EnCl4/Alaris/Relatorio/TG2/PCBs.jpg

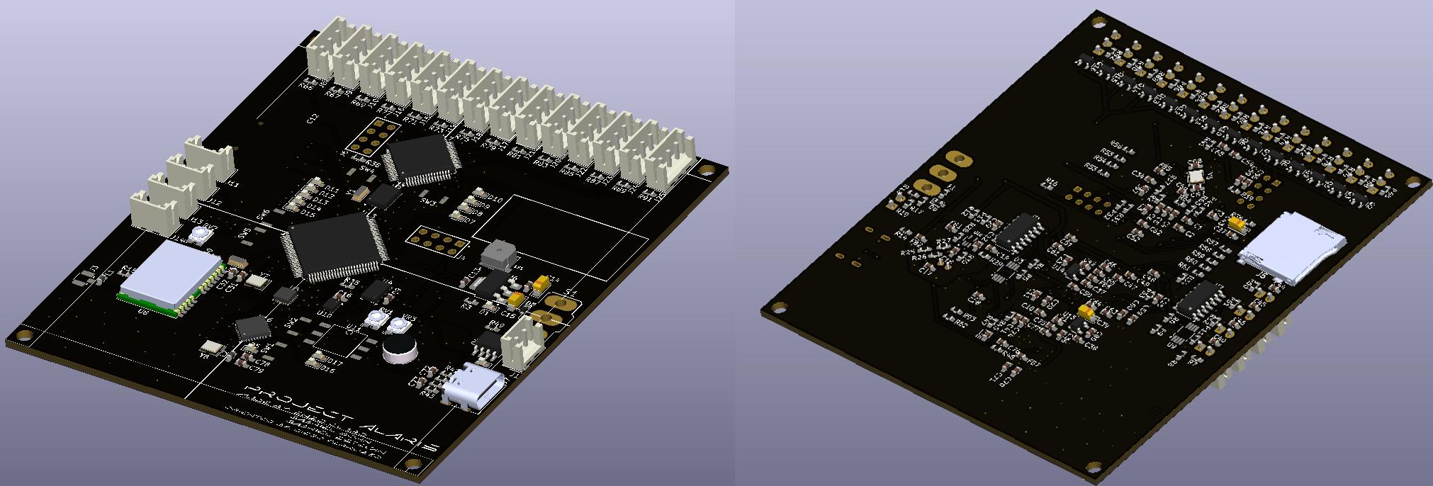
Relatorio/TG2/PCBs.jpg
