EnCl4/Alaris/Relatorio/TG1/Nova pasta/Tubo de pitot.PNG

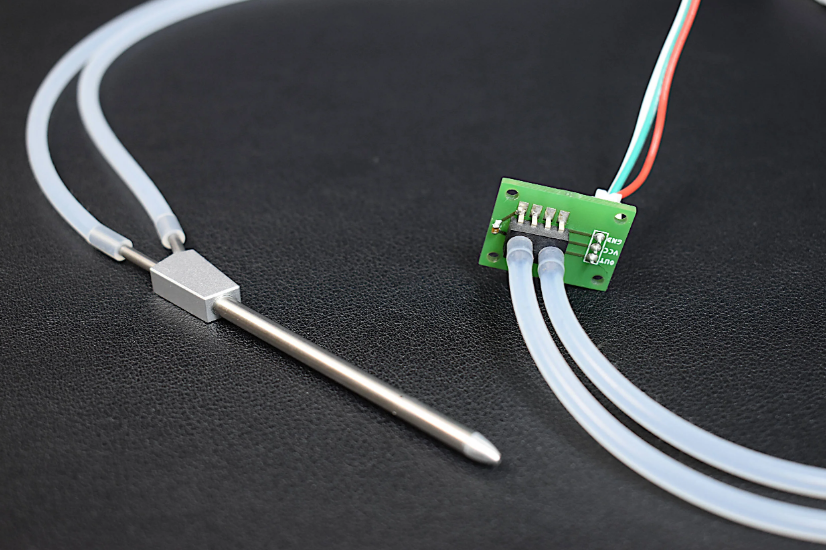
Relatorio/TG1/Nova pasta/Tubo de pitot.PNG
