EnCl4/Alaris/1762131913889.jpg

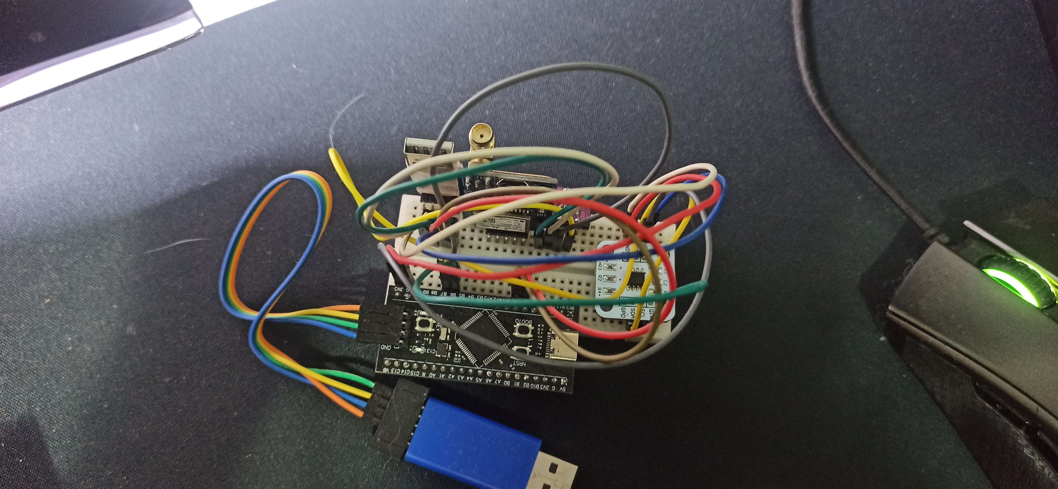
1762131913889.jpg
