EnCl4/Alaris/Capturar.PNG

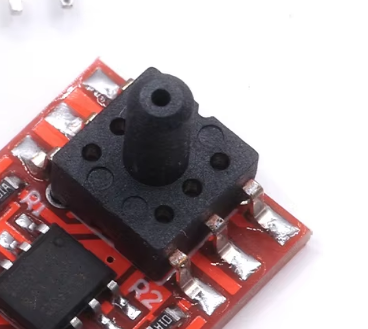
Capturar.PNG
