EnCl4/Alaris/DataGPS2.PNG

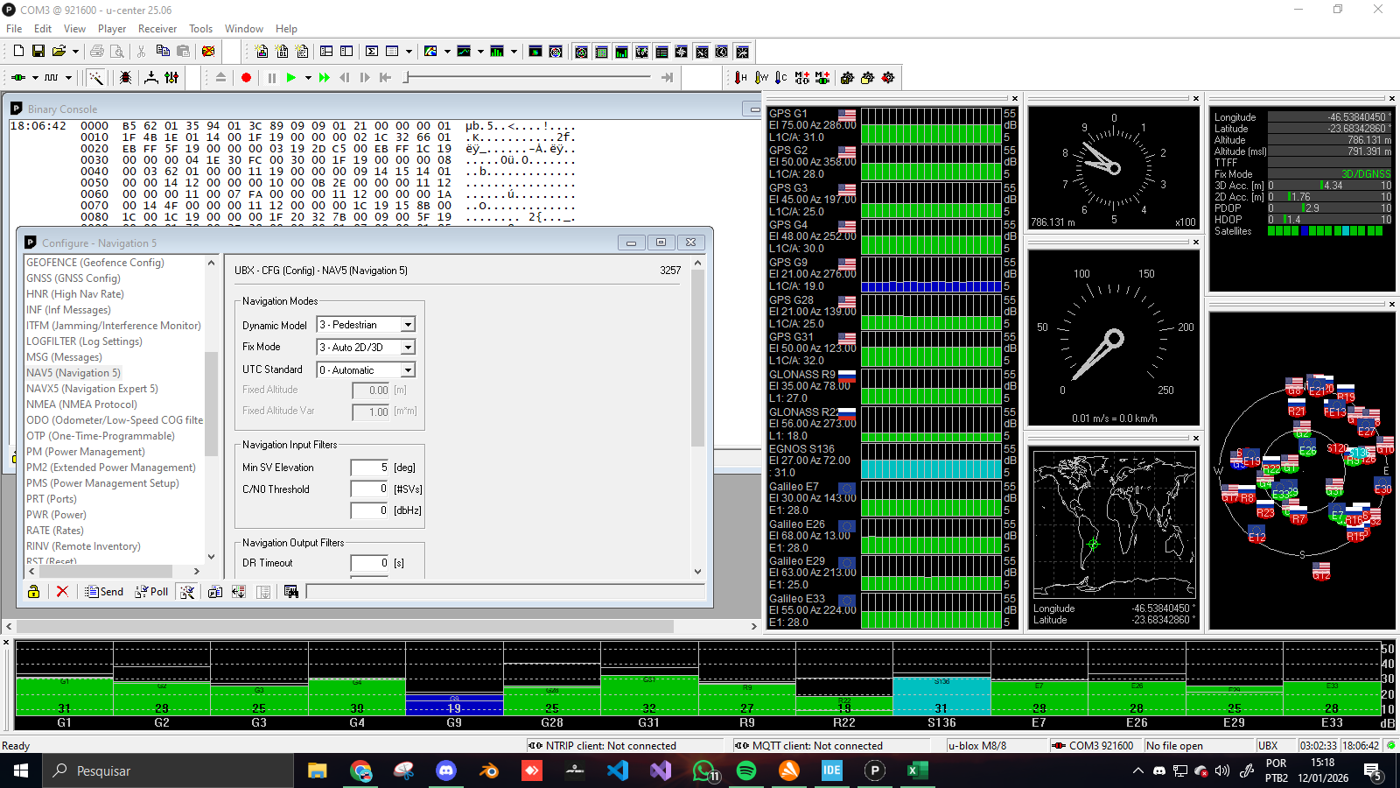
DataGPS2.PNG
