EnCl4/Alaris/GPSdata3.PNG

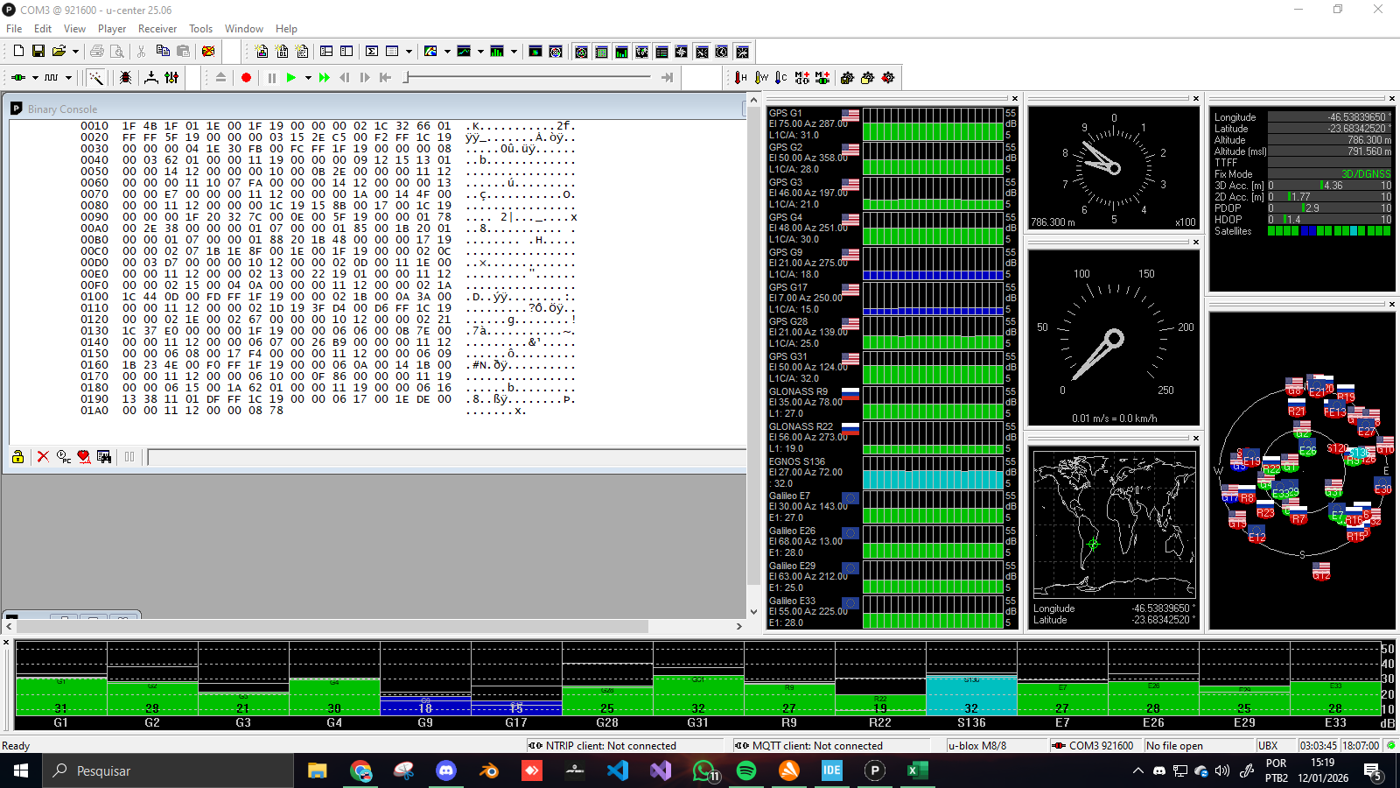
GPSdata3.PNG
