EnCl4/Alaris/GPSData.PNG

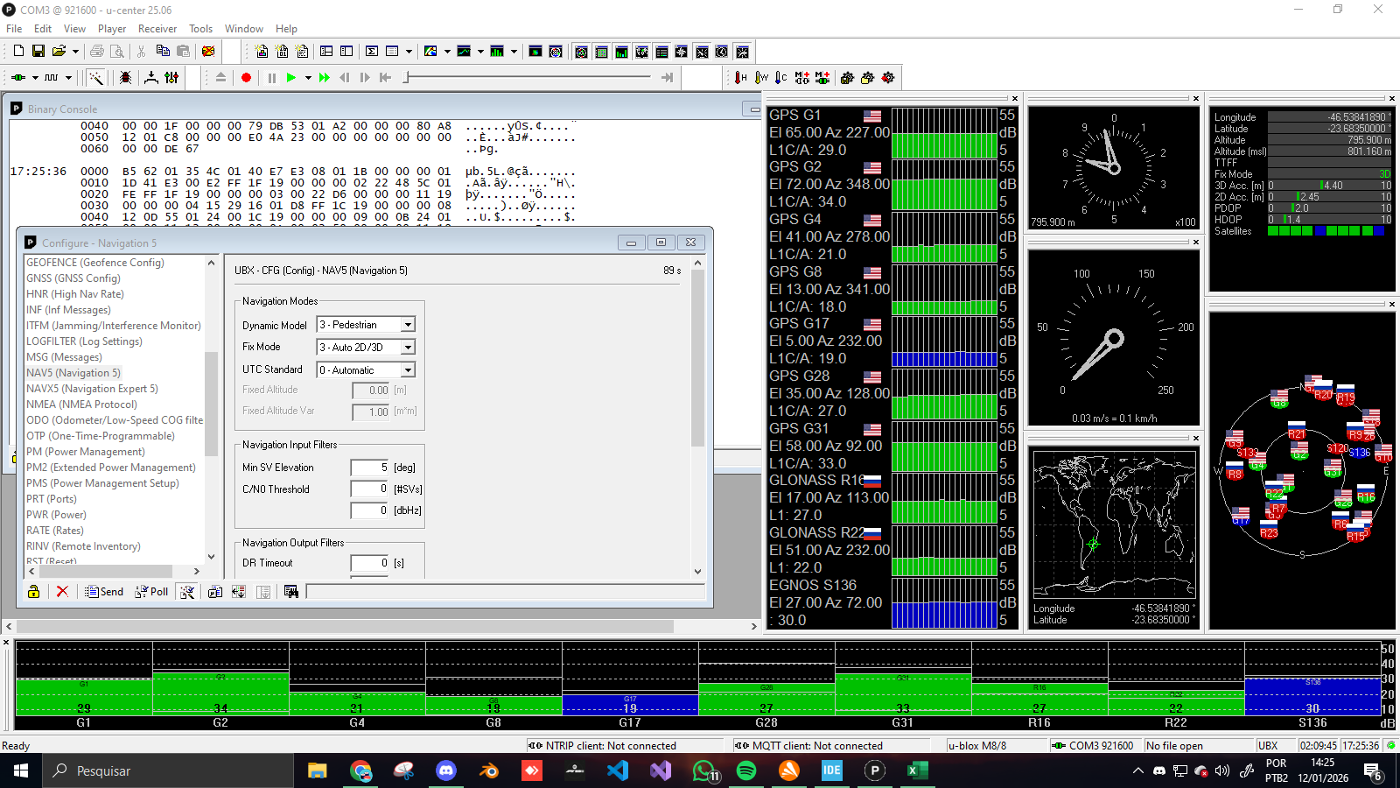
GPSData.PNG
