EnCl4/Alaris/Relatorio/TG1/Nova pasta/bateria-18650.jpg

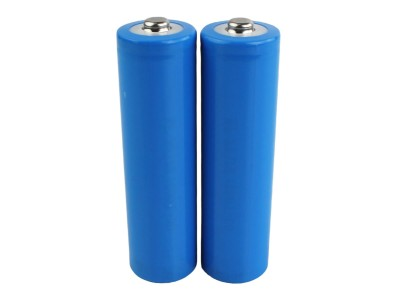
Relatorio/TG1/Nova pasta/bateria-18650.jpg
