EnCl4/Alaris/Relatorio/TG1/Nova pasta/CFD_ASA.png

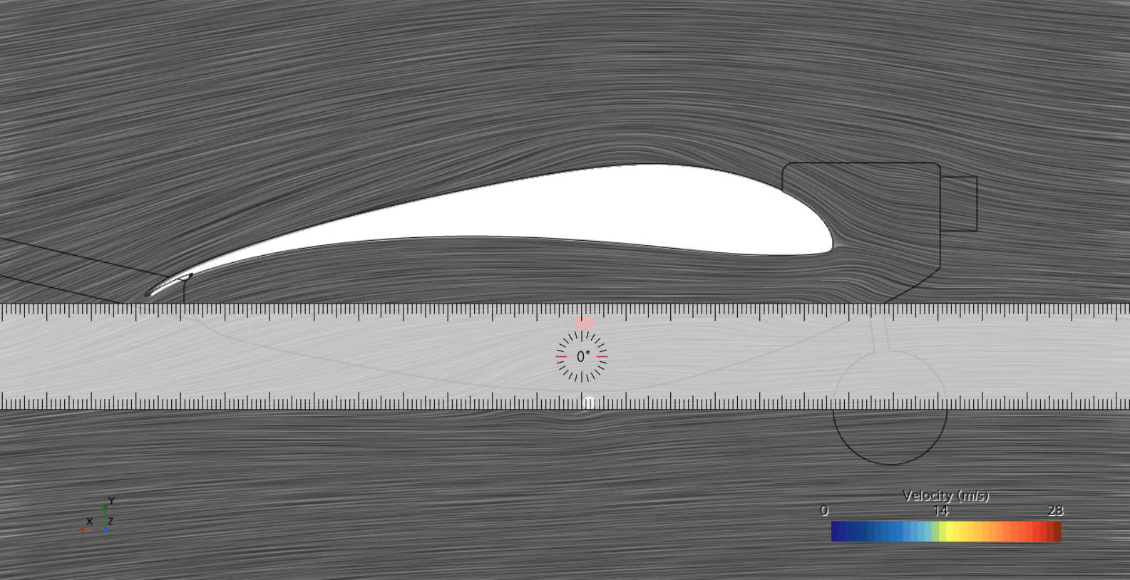
Relatorio/TG1/Nova pasta/CFD_ASA.png
