EnCl4/Alaris/Relatorio/TG1/Nova pasta/DiagramaHardware.png

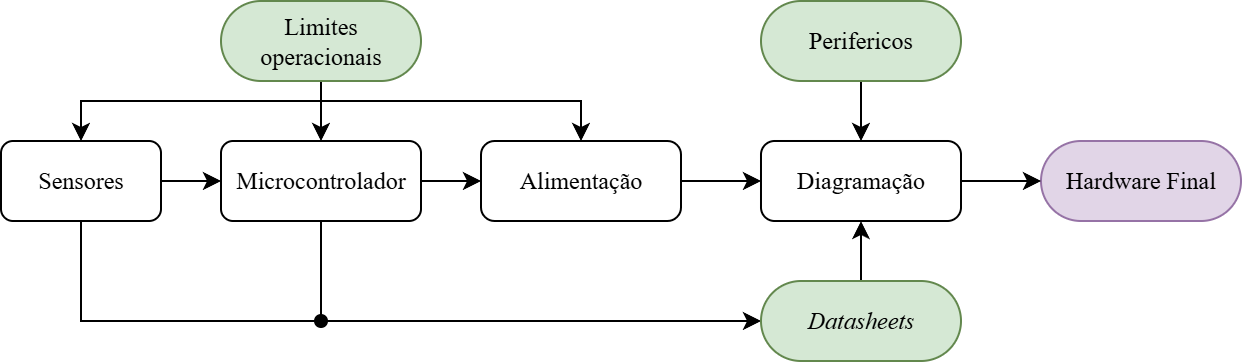
Relatorio/TG1/Nova pasta/DiagramaHardware.png
