EnCl4/Alaris/Relatorio/TG2/FluxoEmbarcado.png

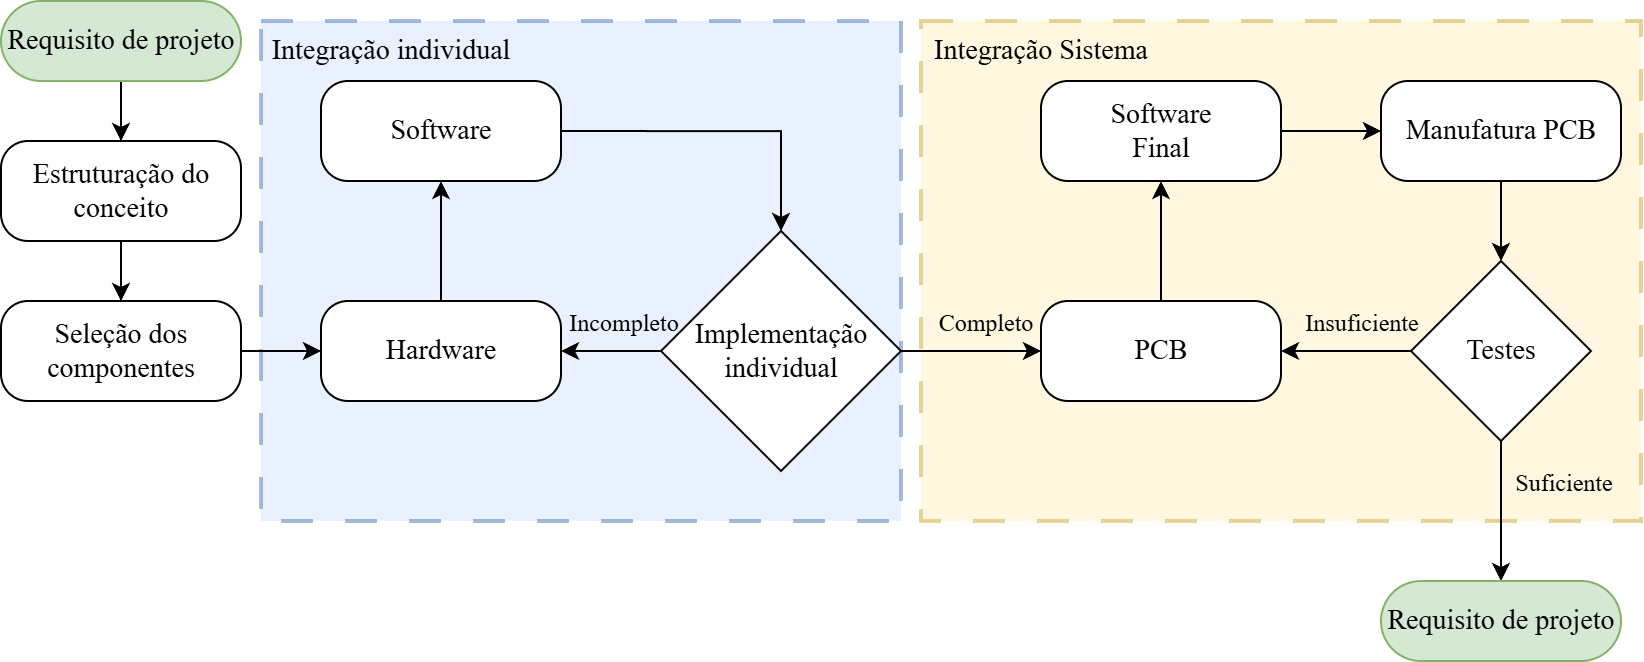
Relatorio/TG2/FluxoEmbarcado.png
