EnCl4/Alaris/Relatorio/TG2/FluxoPDN.png

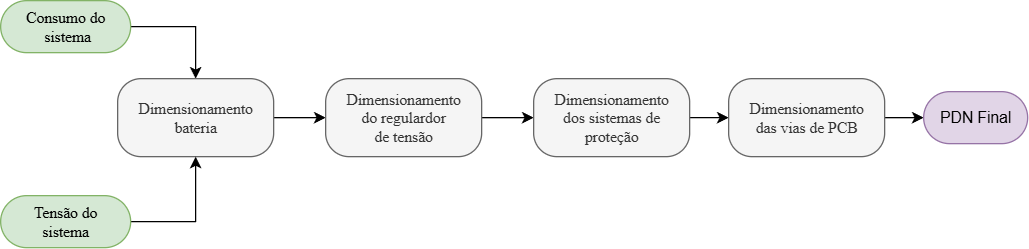
Relatorio/TG2/FluxoPDN.png
