EnCl4/Alaris/Relatorio/TG2/PCBDistribution.jpg

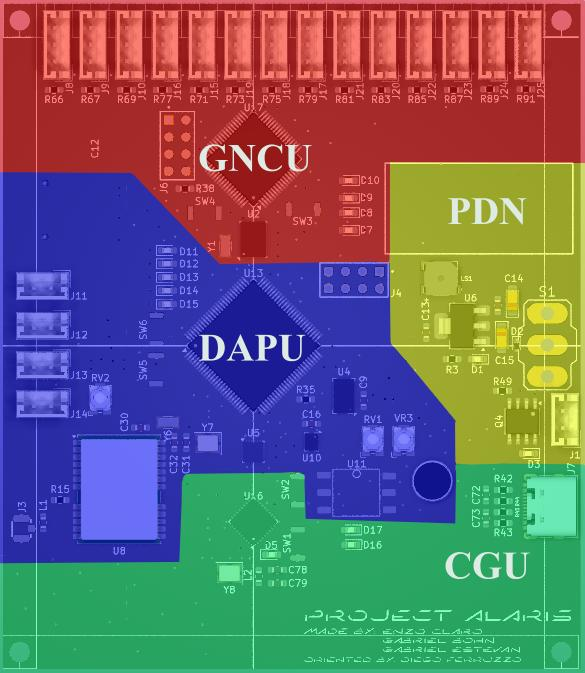
Relatorio/TG2/PCBDistribution.jpg
