EnCl4/Alaris/Relatorio/TG2/SoftwareFlux.png

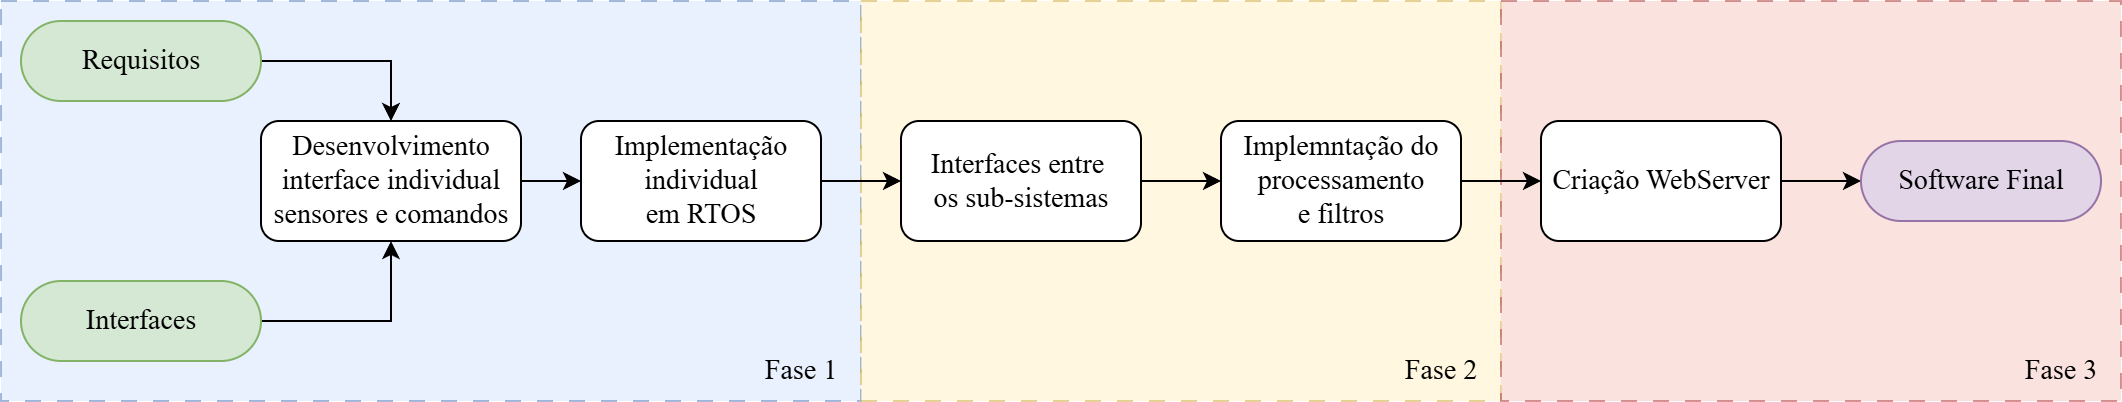
Relatorio/TG2/SoftwareFlux.png
