EnCl4/Alaris/Relatorio/TG2/SubSistemas.png

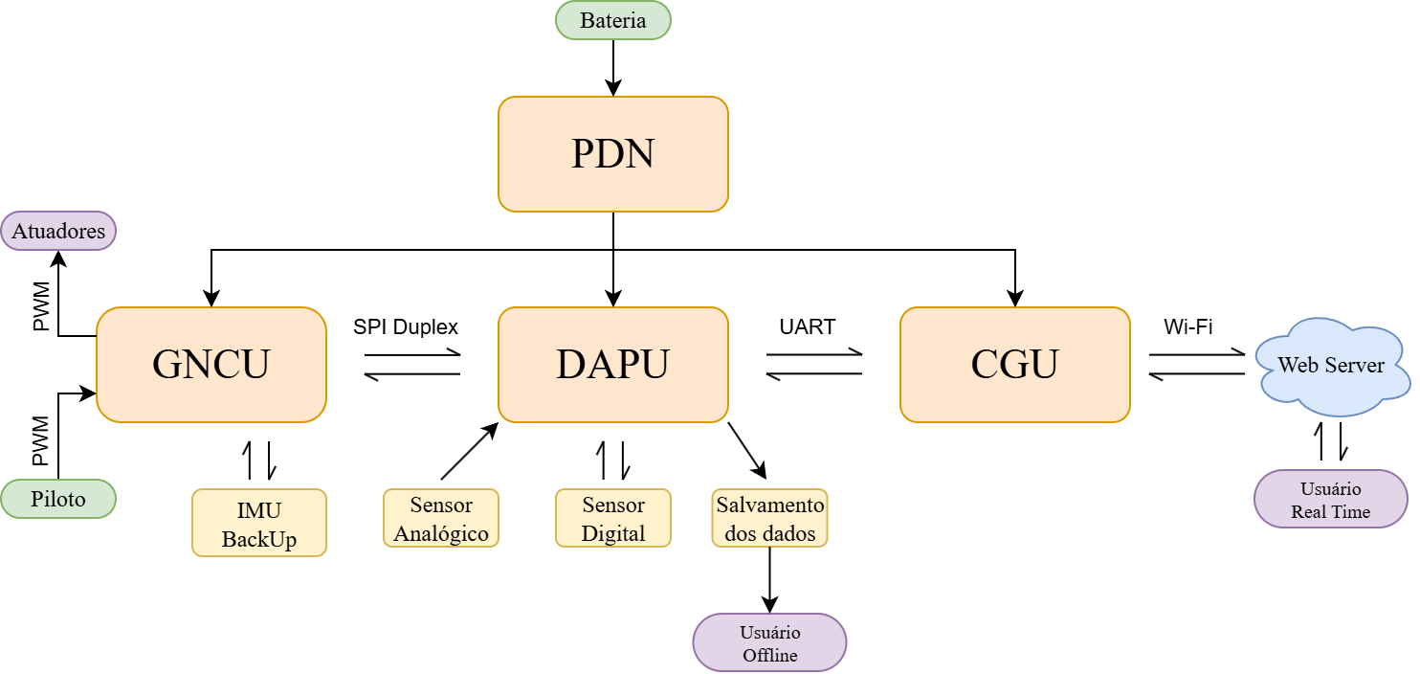
Relatorio/TG2/SubSistemas.png
