EnCl4/Alaris/Alaris - Hardware/Biblioteca/Step/TC33X-2-104E.STEP

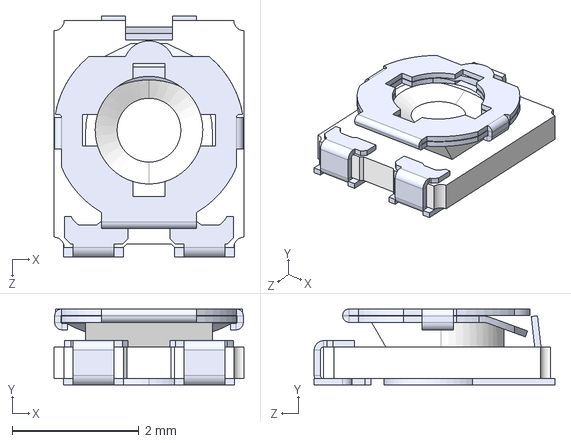
[picture p16: CAD file, 2026-04-19]
Alaris - Hardware/Biblioteca/Step/TC33X-2-104E.STEP
3.00 x 1.20 x 3.80 mm
