EnCl4/Alaris/Alaris - Hardware/Biblioteca/Step/MTMM-104-06-L-D-260.stp

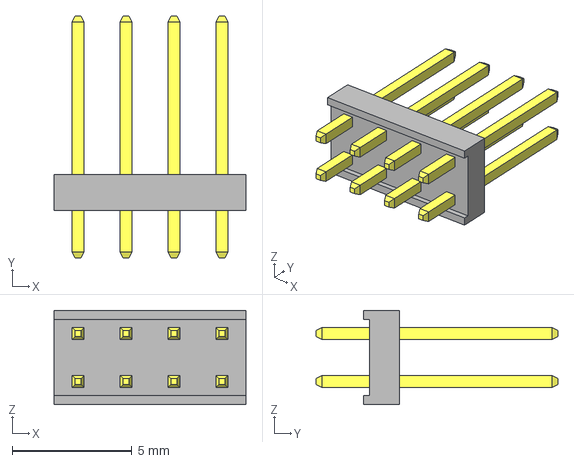
[picture p17: CAD file, 2026-04-19]
Alaris - Hardware/Biblioteca/Step/MTMM-104-06-L-D-260.stp
8.00 x 10.1 x 3.94 mm
MTMM-104-06-L-D-260_pins
MTMM-104-06-L-D-260_body
