EnCl4/Alaris/Alaris - Hardware/Biblioteca/Step/Buzzer5mm.step

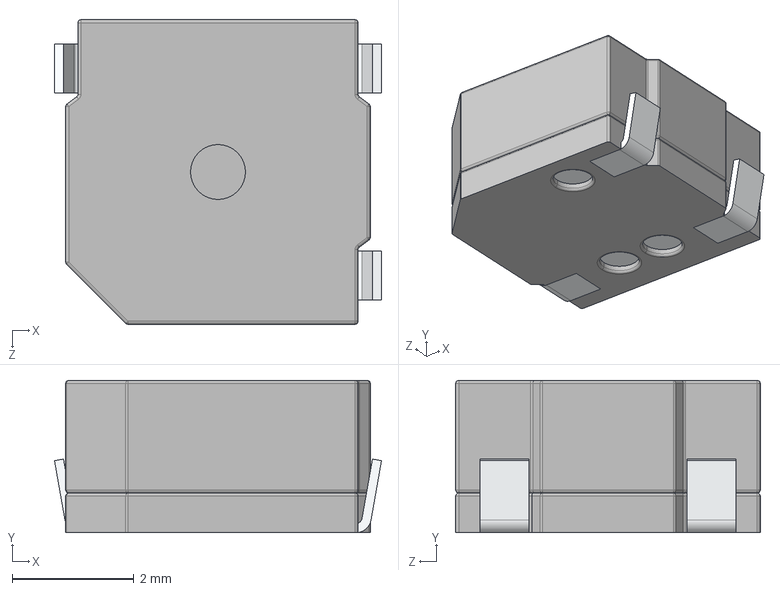
[picture p18: CAD file, 2026-04-19]
Alaris - Hardware/Biblioteca/Step/Buzzer5mm.step
5.37 x 2.50 x 5.00 mm
