EnCl4/Alaris/Alaris - Hardware/Biblioteca/Step/NEO-M8N-0-10.STEP

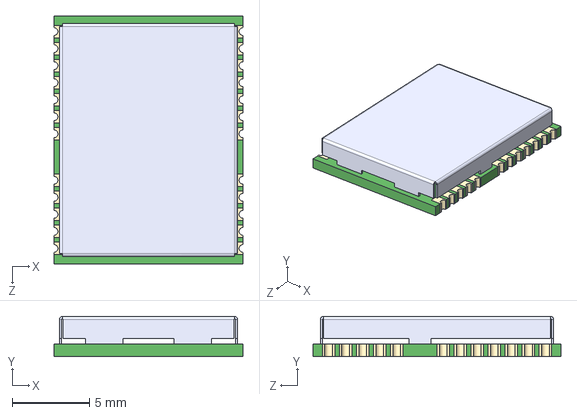
[picture p19: CAD file, 2026-04-19]
Alaris - Hardware/Biblioteca/Step/NEO-M8N-0-10.STEP
12.2 x 2.60 x 16.0 mm
