EnCl4/Alaris/Alaris - Hardware/Biblioteca/Step/ESP32-C3.STEP

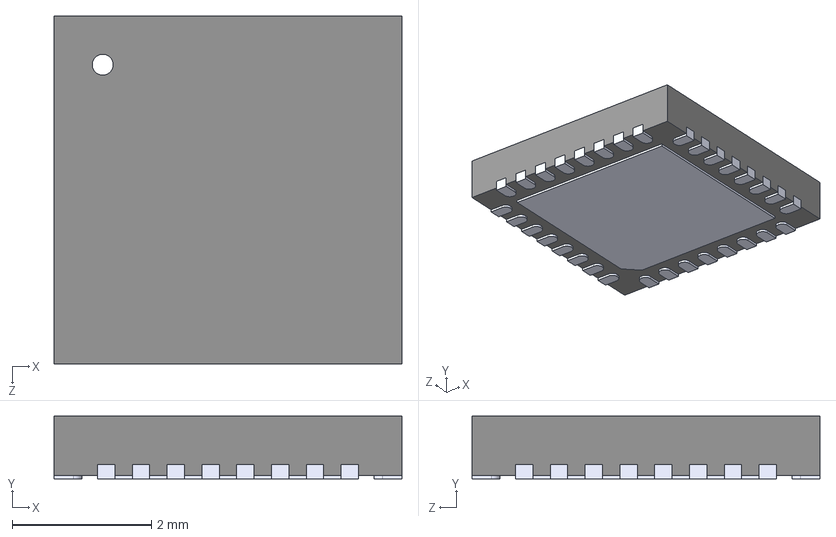
[picture p20: CAD file, 2026-04-19]
Alaris - Hardware/Biblioteca/Step/ESP32-C3.STEP
5.00 x 0.9 x 5.00 mm
