EnCl4/Alaris/Alaris - Hardware/Biblioteca/Step/Mic6022.step

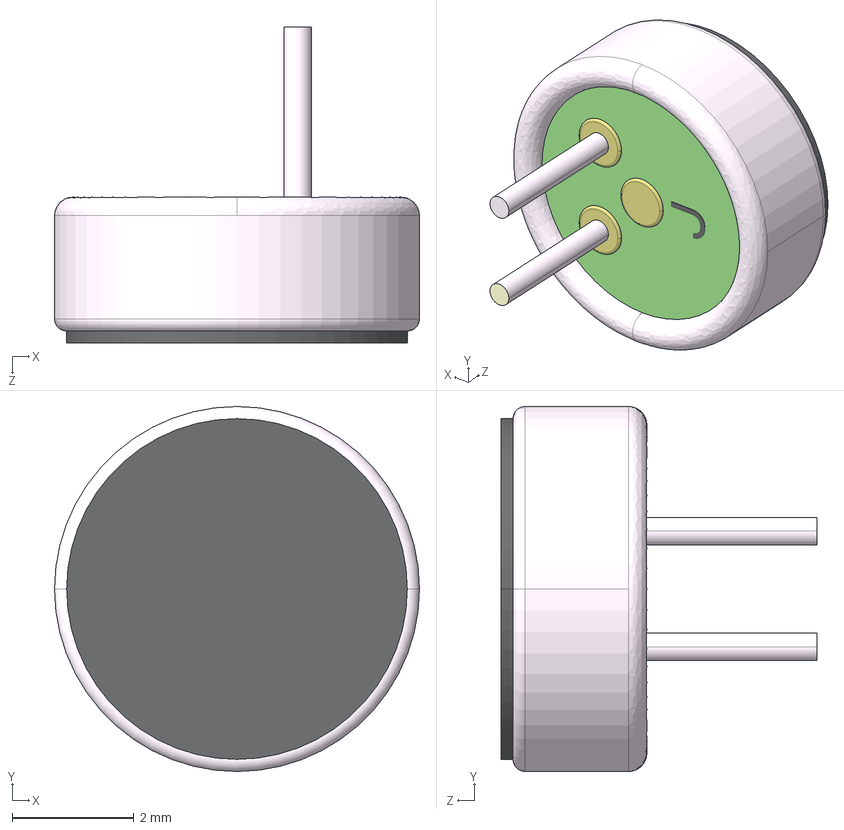
[picture p21: CAD file, 2026-04-19]
Alaris - Hardware/Biblioteca/Step/Mic6022.step
6.00 x 6.00 x 5.20 mm
