EnCl4/Alaris/Alaris - Hardware/Biblioteca/Step/MSD-1-A--3DModel-STEP-1.STEP

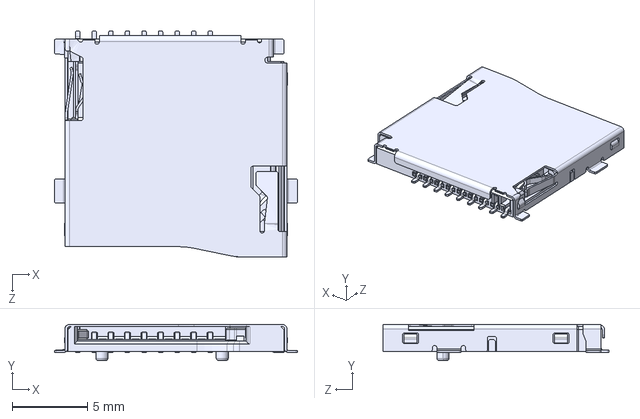
[picture p22: CAD file, 2026-04-19]
Alaris - Hardware/Biblioteca/Step/MSD-1-A--3DModel-STEP-1.STEP
16.1 x 2.40 x 15.0 mm
