EnCl4/Alaris/Alaris - Hardware/Biblioteca/Step/USB4105GFA060--3DModel-STEP-56544.STEP

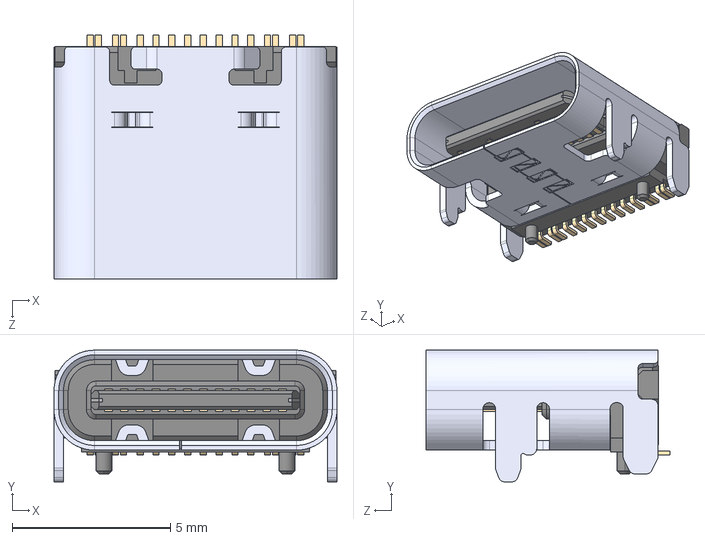
[picture p23: CAD file, 2026-04-19]
Alaris - Hardware/Biblioteca/Step/USB4105GFA060--3DModel-STEP-56544.STEP
8.94 x 4.16 x 7.71 mm
