EnCl4/Alaris/Alaris - Hardware/Biblioteca/Step/ICM-20648--3DModel-STEP-56544.STEP

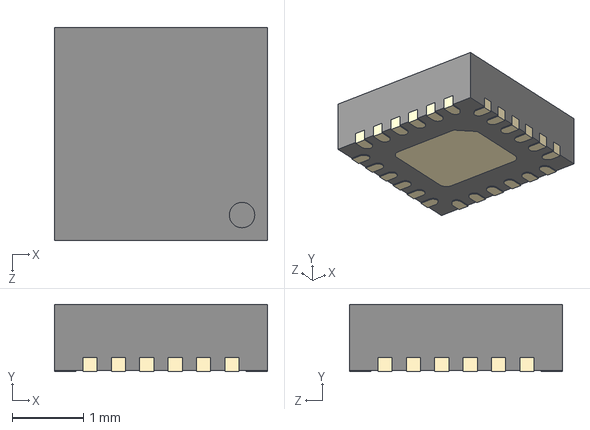
[picture p24: CAD file, 2026-04-19]
Alaris - Hardware/Biblioteca/Step/ICM-20648--3DModel-STEP-56544.STEP
3.00 x 0.95 x 3.00 mm
