EnCl4/Alaris/Alaris - Hardware/Biblioteca/Step/MAX4466EXK.step

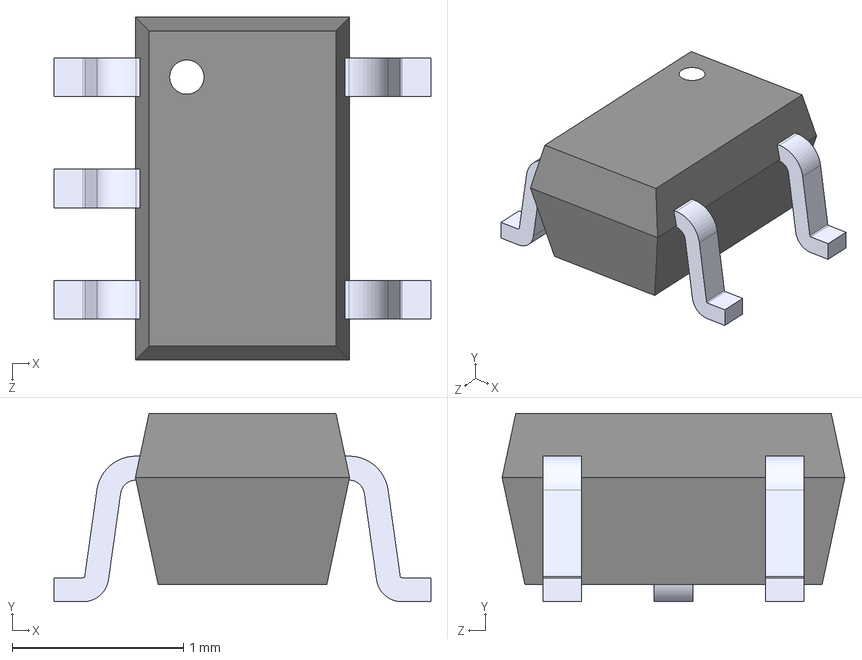
[picture p25: CAD file, 2026-03-01]
Alaris - Hardware/Biblioteca/Step/MAX4466EXK.step
2.20 x 1.10 x 2.00 mm
