EnCl4/Alaris/Alaris - Hardware/Biblioteca/Step/LM358D.step

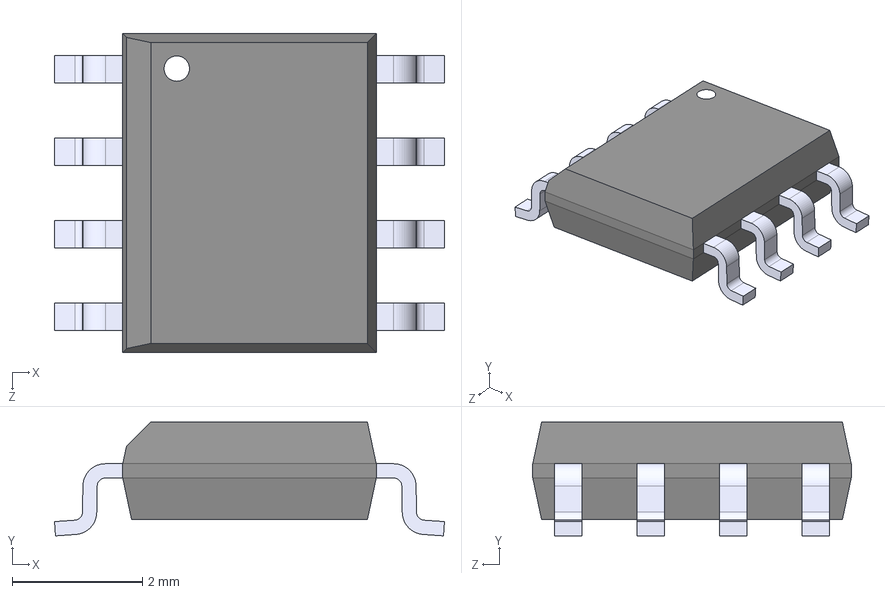
[picture p26: CAD file, 2026-03-01]
Alaris - Hardware/Biblioteca/Step/LM358D.step
6.00 x 1.75 x 4.90 mm
