EnCl4/Alaris/Alaris - Hardware/Biblioteca/Step/BNO055.step

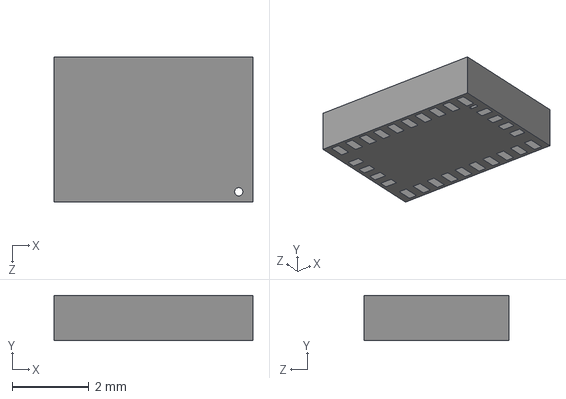
[picture p27: CAD file, 2026-02-13]
Alaris - Hardware/Biblioteca/Step/BNO055.step
5.20 x 1.18 x 3.80 mm
