EnCl4/Alaris/Alaris - Hardware/Biblioteca/Step/MTSW-101-X-X-D-X.step

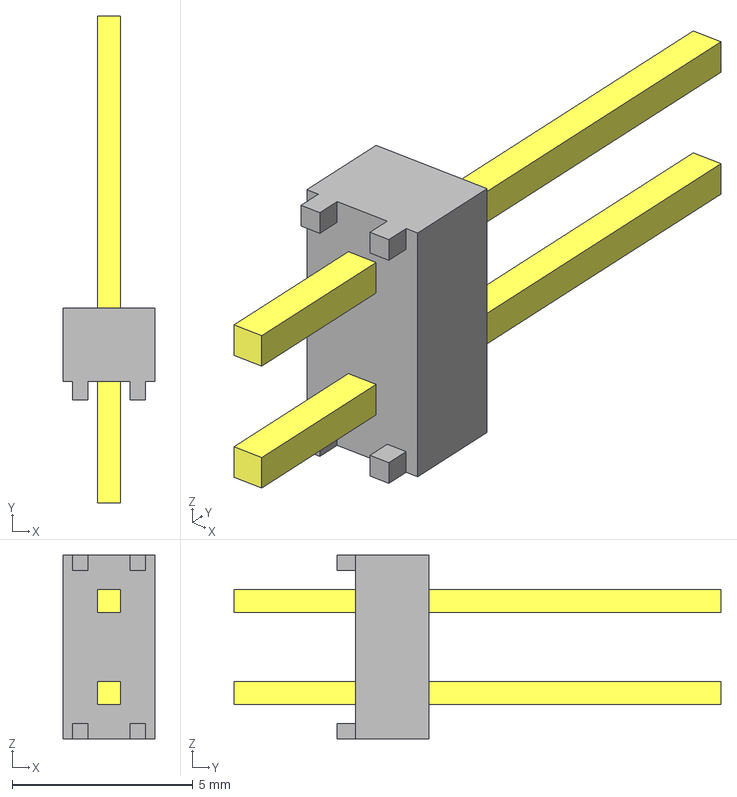
[picture p28: CAD file, 2026-02-13]
Alaris - Hardware/Biblioteca/Step/MTSW-101-X-X-D-X.step
2.54 x 13.5 x 5.08 mm
MTSW-101-08-S-D-318_body
MTSW-101-08-D-318
