EnCl4/Alaris/Alaris - Hardware/Biblioteca/Step/BMP390L.step

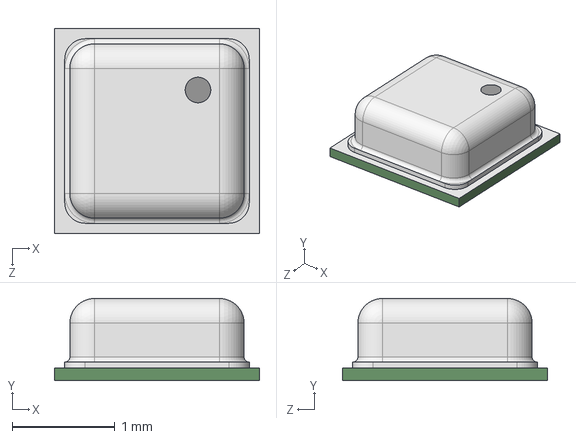
[picture p29: CAD file, 2026-02-13]
Alaris - Hardware/Biblioteca/Step/BMP390L.step
2.00 x 0.8 x 2.00 mm
