EnCl4/Alaris/(list of files, cad)

Other CAD files:
Alaris - Hardware/Biblioteca/Step/636101111001.step
