EnCl4/Alaris/benchmark.xlsx

Sheet: SD
prescaler:32 BoudRate: 2.625Mbits/s |  |  |  |  |  | prescaler:8 BoudRate: 10.5Mbits/s |  |  |  |  |  | prescaler:4 BoudRate: 21.0Mbits/s |  |  |  |  |  | prescaler:2 BoudRate: 42.0Mbits/s
DMA |  |  | NO DMA |  |  | DMA |  |  | NO DMA |  |  | DMA |  |  | NO DMA |  |  | DMA |  |  | NO DMA
TestNumber | Write [Kb/s] | Read [Kb/s] | TestNumber | Write [Kb/s] | Read [Kb/s] | TestNumber | Write [Kb/s] | Read [Kb/s] | TestNumber | Write [Kb/s] | Read [Kb/s] | TestNumber | Write [Kb/s] | Read [Kb/s] | TestNumber | Write [Kb/s] | Read [Kb/s] | TestNumber | Write [Kb/s] | Read [Kb/s] | TestNumber | Write [Kb/s] | Read [Kb/s]
1 | 208 | 247 | 1 | 207 | 85 | 1 | 411 | 598 | 1 | 379 | 101 | 1 | 496 | 773 | 1 | 453 | 112 | 1 | 0 | 0 | 1 | 0 | 0
2 | 208 | 248 | 2 | 207 | 85 | 2 | 398 | 597 | 2 | 398 | 101 | 2 | 492 | 782 | 2 | 448 | 111 | 2 | 0 | 0 | 2 | 0 | 0
3 | 208 | 247 | 3 | 204 | 85 | 3 | 418 | 598 | 3 | 391 | 101 | 3 | 490 | 782 | 3 | 444 | 112 | 3 | 0 | 0 | 3 | 0 | 0
4 | 199 | 248 | 4 | 210 | 85 | 4 | 411 | 594 | 4 | 390 | 101 | 4 | 474 | 782 | 4 | 431 | 111 | 4 | 0 | 0 | 4 | 0 | 0
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
