EnCl4/Alaris/Relatorio/TG1/Resultados/GPSWorking.PNG

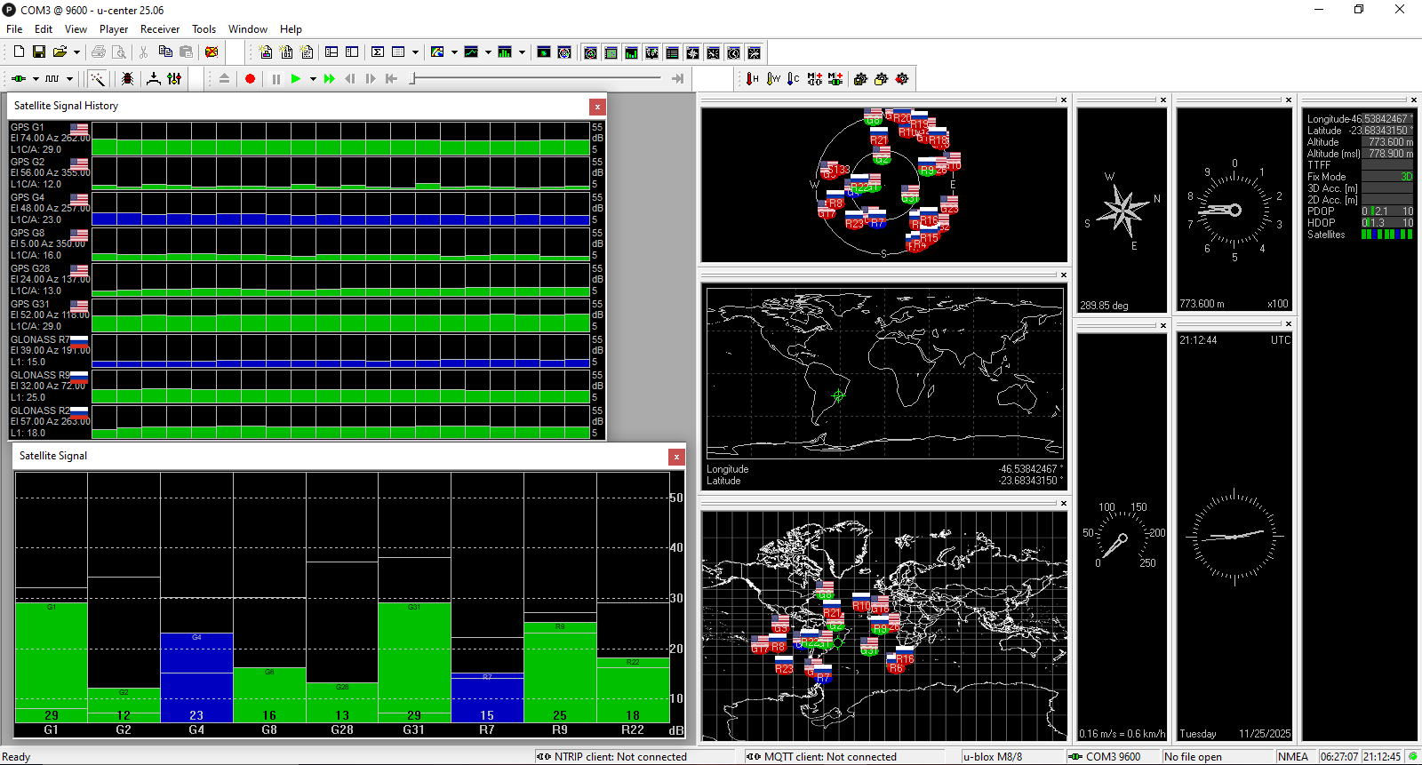
Relatorio/TG1/Resultados/GPSWorking.PNG
