EnCl4/Alaris/Alaris - Hardware/AlarisV1.0/AlarisV1.0.pdf

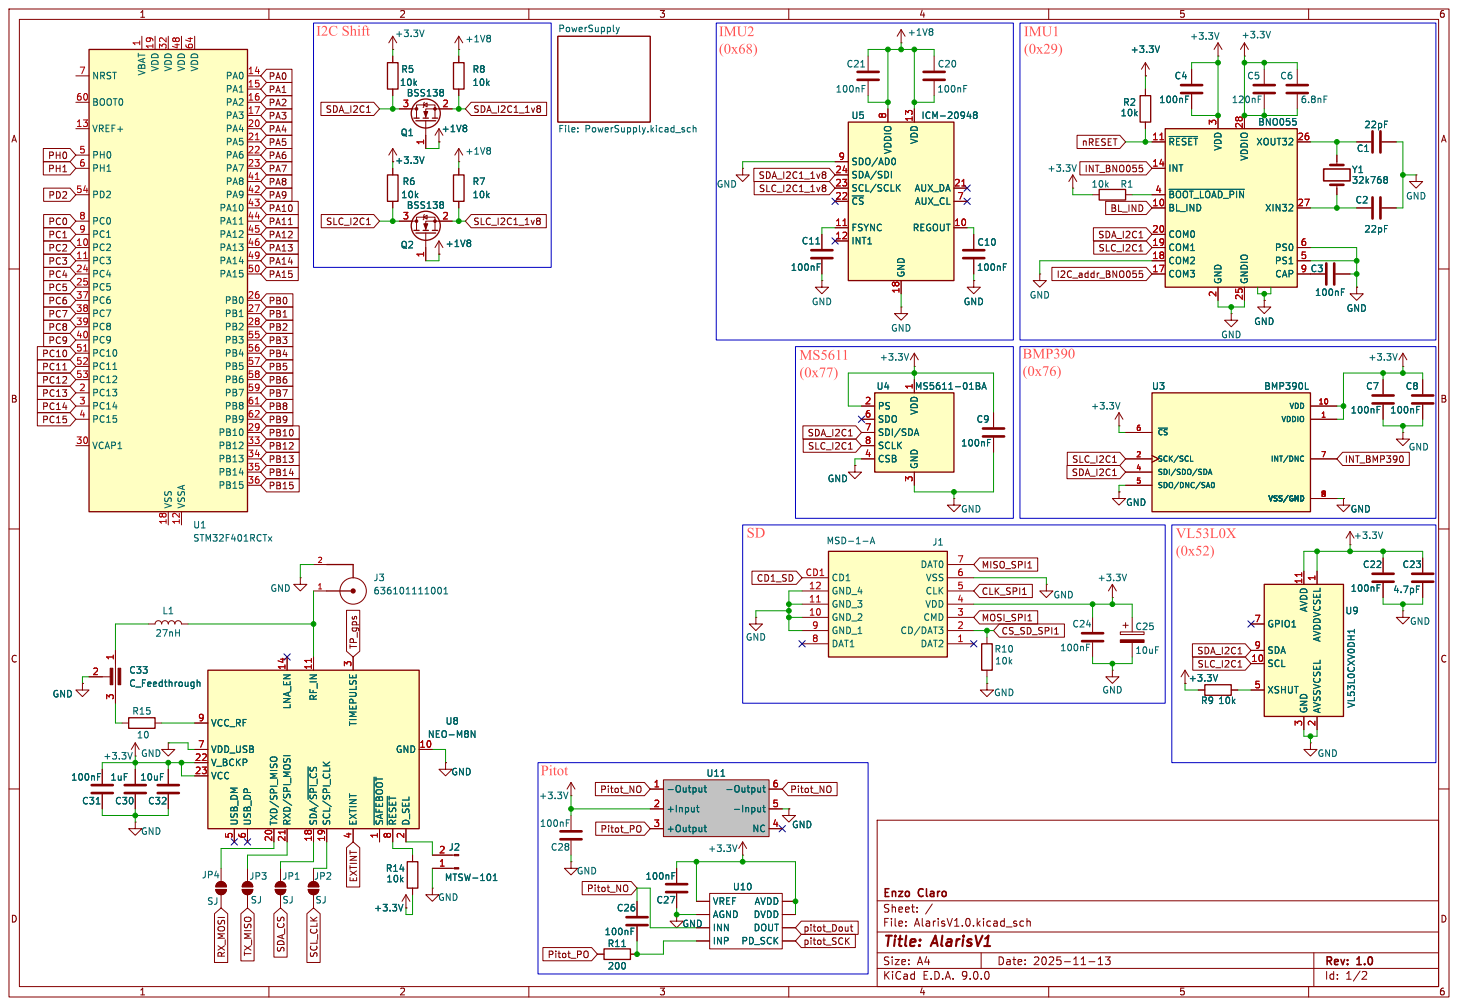
[picture p31: page 1]

1 VDD 19 VDD 32 VSS 18 VDD 48 VSSA 12 VDD 64 PA0 14 PA1 15 PA2 16 PA3 17 PA4 20 PA5 21 PA6 22 PA7 23 PA8 41 PA9 42 PA10 43 PA11 44 PA12 45 PA13 46 PA14 49 PA15 50 PB0 26 PB1 27 PB2 28 PB3 55 PB4 56 PB5 57 PB6 58 PB7 59 PB8 61 PB9 62 PB10 29 PB12 33 PB13 34 PB14 35 PB15 36 U1STM32F401RCTx

8 GND 18 VDD 13 AUX_DA 21 AUX_CL 7 REGOUT 10GND GND

8 GND 18 VDD 13 AUX_DA 21 AUX_CL 7 REGOUT 10 U5 ICM-20948

2 VDDIO 28 GNDIO 25 XOUT32 26 XIN32 27 PS0 6 PS1 5 CAP 9 BNO055 GND

2 VDDIO 28 GNDIO 25 XOUT32 26 XIN32 27 PS0 6 PS1 5 CAP 9 GND

6 TXD/SPI_MISO 20 RXD/SPI_MOSI 21 SDA/~{SPI_CS} 18 SCL/SPI_CLK 19 EXTINT

File: AlarisV1.0.kicad_sch Sheet: / Enzo Claro
