EnCl4/Alaris/(list of files, drawings)

Other design files:
Alaris - Hardware/AlarisV1.0/freerouting.dsn
