EnCl4/Alaris/Alaris - Hardware/AlarisV1.0/AlarisV1.0.kicad_pcb

## KiCad design Alaris - Hardware/AlarisV1.0/AlarisV1.0.kicad_pcb (2026-04-19)

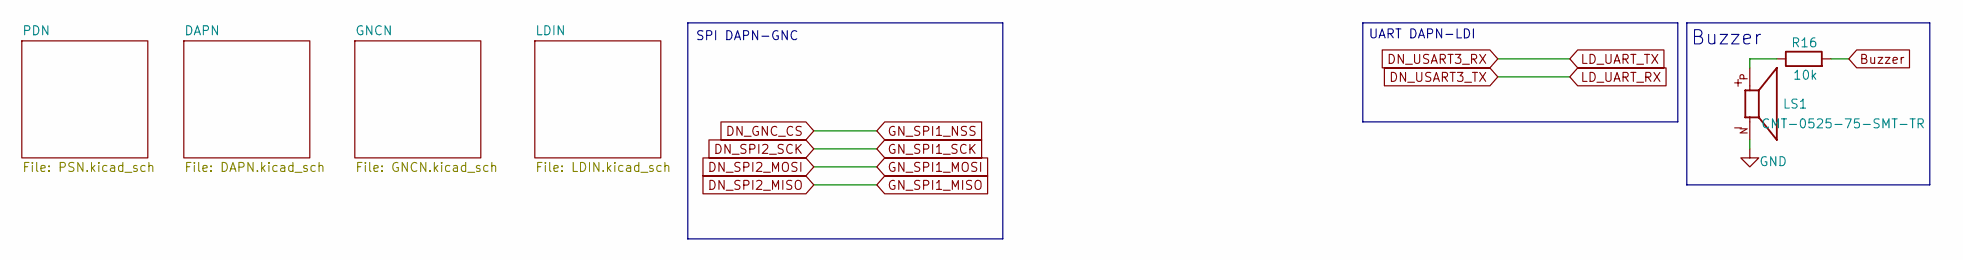
[picture p40: schematic AlarisV1.0.kicad_sch, AlarisV1]

Parts:
LS1: CMT-0525-75-SMT-TR; Buzzer5mm; PARTREV 1.0
R16: 10k; R_0603_1608Metric_Pad0.98x0.95mm_HandSolder

Connections:
Buzzer: R16.2; also elsewhere on the board
GND: LS1.N; also elsewhere on the board
unnamed: LS1.P, R16.1

Notes on the sheet:
Buzzer
SPI DAPN-GNC
UART DAPN-LDI

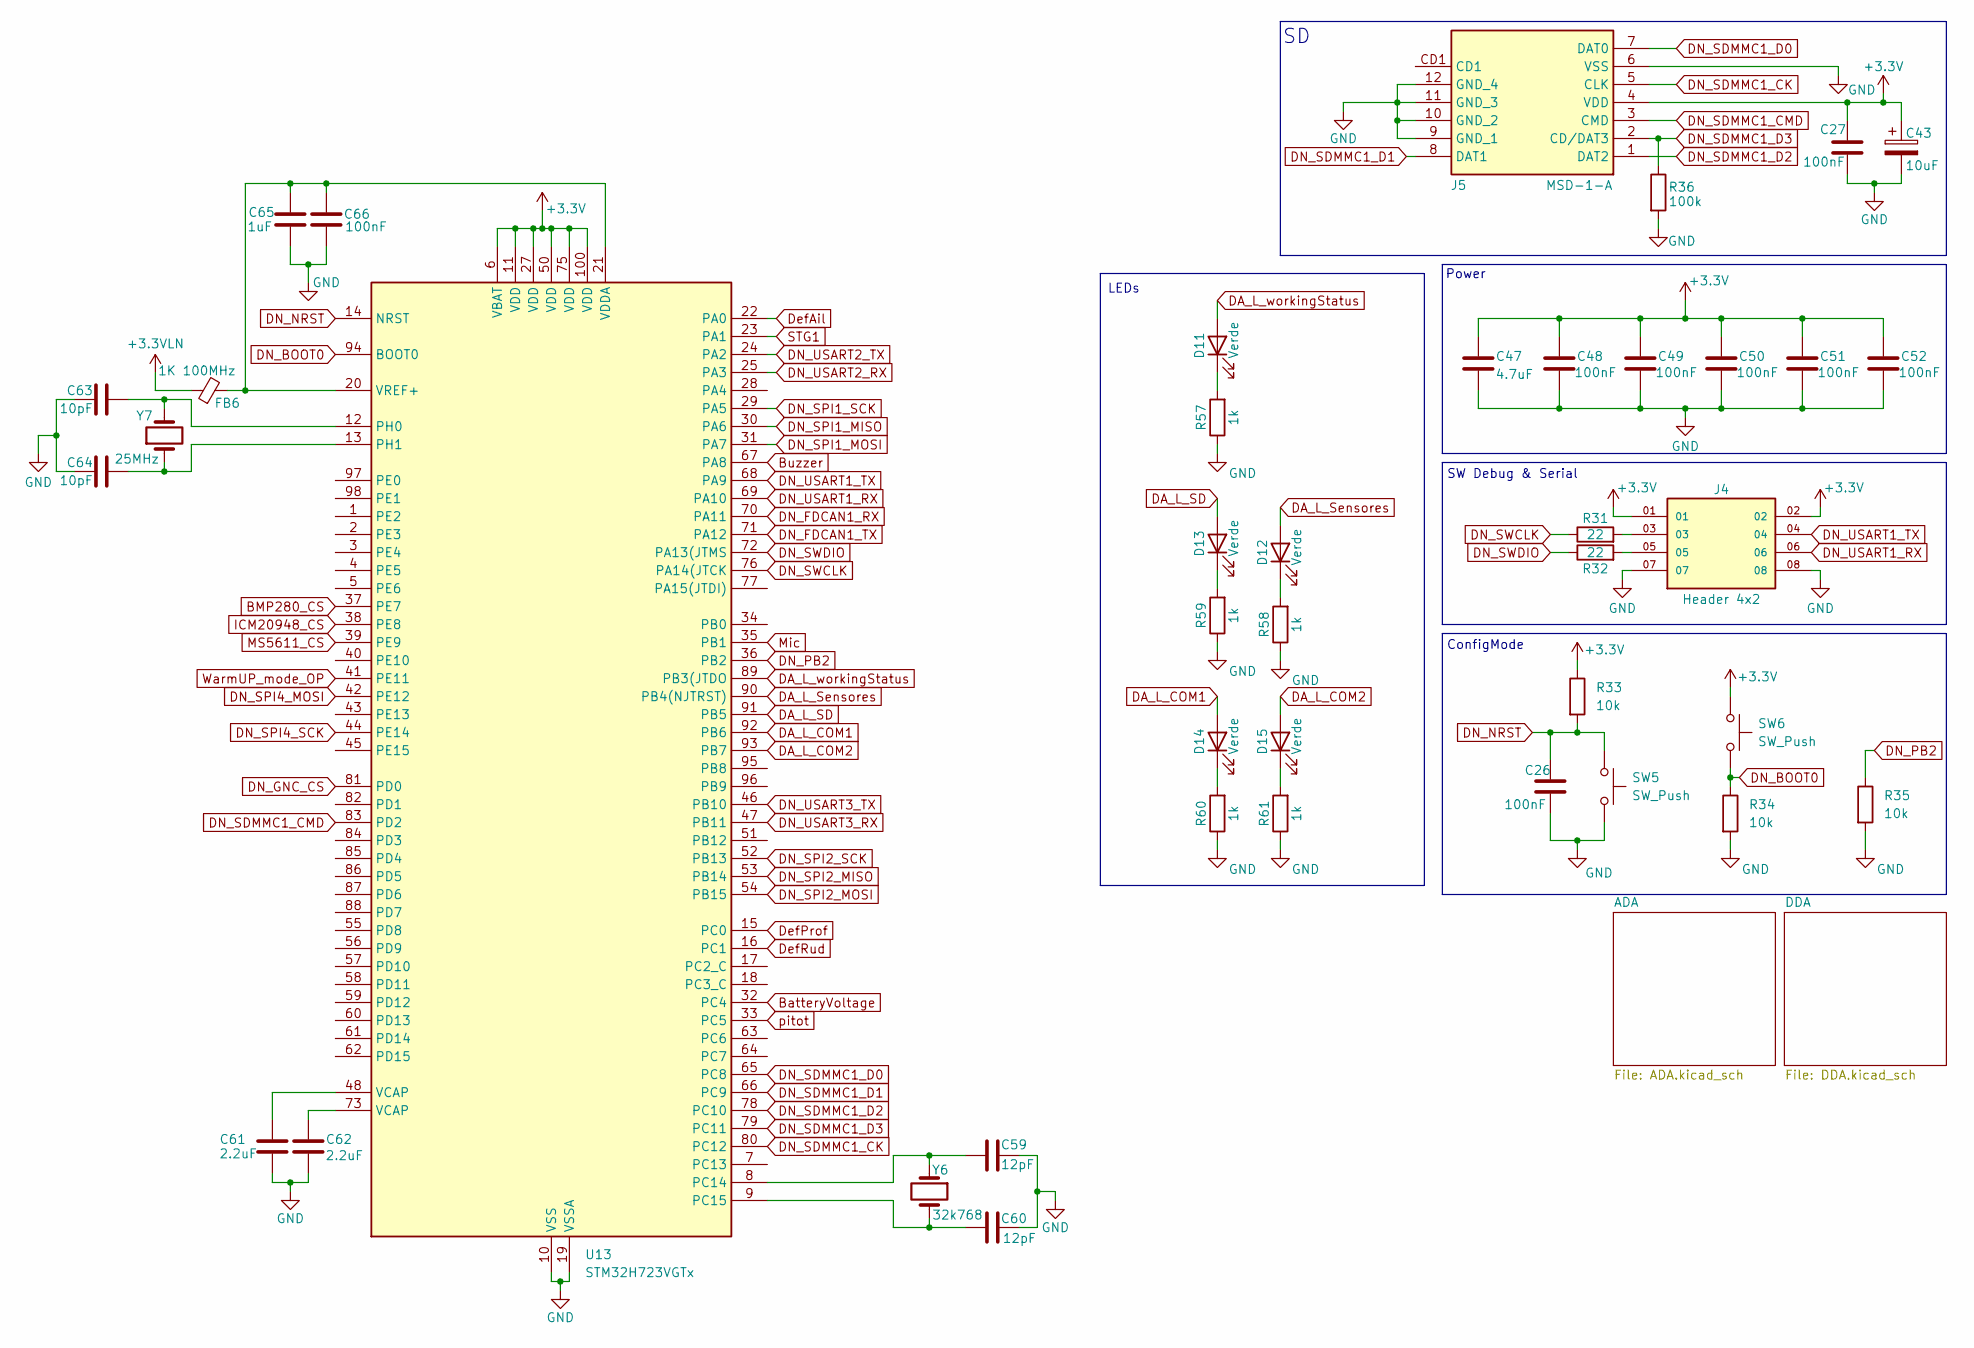
[picture p41: schematic DAPN.kicad_sch, AlarisV1]

Parts:
C26, C27, C48, C49, C50, C51, C52, C66: 100nF; C_0603_1608Metric_Pad1.08x0.95mm_HandSolder
C43: 10uF; CP_EIA-3216-18_Kemet-A_Pad1.58x1.35mm_HandSolder
C47: 4.7uF; C_0603_1608Metric_Pad1.08x0.95mm_HandSolder
C59, C60: 12pF; C_0603_1608Metric_Pad1.08x0.95mm_HandSolder
C61, C62: 2.2uF; C_0603_1608Metric_Pad1.08x0.95mm_HandSolder
C63, C64: 10pF; C_0603_1608Metric_Pad1.08x0.95mm_HandSolder
C65: 1uF; C_0603_1608Metric_Pad1.08x0.95mm_HandSolder
D11, D12, D13, D14, D15: Verde; LED_0603_1608Metric_Pad1.05x0.95mm_HandSolder
FB6: 1K 100MHz; C_0603_1608Metric_Pad1.08x0.95mm_HandSolder
J4: Header 4x2; Header4x2; PARTREV R
J5: MSD-1-A; MSD1A; Mouser Part Number 179-MSD-1-A
R31, R32: 22; R_0603_1608Metric_Pad0.98x0.95mm_HandSolder
R33, R34, R35: 10k; R_0603_1608Metric_Pad0.98x0.95mm_HandSolder
R36: 100k; R_0603_1608Metric_Pad0.98x0.95mm_HandSolder
R57, R58, R59, R60, R61: 1k; R_0603_1608Metric_Pad0.98x0.95mm_HandSolder
SW5, SW6: SW_Push; SKRK
U13: STM32H723VGTx; LQFP-100_14x14mm_P0.5mm
Y6: 32k768; Crystal_SMD_3215-2Pin_3.2x1.5mm
Y7: 25MHz; Crystal_SMD_3225-4Pin_3.2x2.5mm

Connections:
+3.3V: C27.1, C43.1, C47.1, C48.1, C49.1, C50.1, C51.1, C52.1, J4.01, J4.02, J5.4 (VDD), R33.1, SW6.1, U13.6 (VBAT), U13.11 (VDD), U13.27 (VDD), U13.50 (VDD), U13.75 (VDD), U13.100 (VDD); also elsewhere on the board
+3.3VLN: FB6.1; also elsewhere on the board
BMP280_CS: U13.37 (PE7); also elsewhere on the board
BatteryVoltage: U13.32 (PC4); also elsewhere on the board
Buzzer: U13.67 (PA8); also elsewhere on the board
DA_L_COM1: D14.2 (A), U13.92 (PB6)
DA_L_COM2: D15.2 (A), U13.93 (PB7)
DA_L_SD: D13.2 (A), U13.91 (PB5)
DA_L_Sensores: D12.2 (A), U13.90 (PB4(NJTRST))
DA_L_workingStatus: D11.2 (A), U13.89 (PB3(JTDO)
DN_BOOT0: R34.1, SW6.2, U13.94 (BOOT0)
DN_FDCAN1_RX: U13.70 (PA11)
DN_FDCAN1_TX: U13.71 (PA12)
DN_NRST: C26.2, R33.2, SW5.1, U13.14 (NRST)
DN_PB2: R35.1, U13.36 (PB2)
DN_SDMMC1_CK: J5.5 (CLK), U13.80 (PC12)
DN_SDMMC1_CMD: J5.3 (CMD), U13.83 (PD2)
DN_SDMMC1_D0: J5.7 (DAT0), U13.65 (PC8)
DN_SDMMC1_D1: J5.8 (DAT1), U13.66 (PC9)
DN_SDMMC1_D2: J5.1 (DAT2), U13.78 (PC10)
DN_SDMMC1_D3: J5.2 (CD/DAT3), R36.1, U13.79 (PC11)
DN_SPI1_MISO: U13.30 (PA6); also elsewhere on the board
DN_SPI1_MOSI: U13.31 (PA7); also elsewhere on the board
DN_SPI1_SCK: U13.29 (PA5); also elsewhere on the board
DN_SPI4_MOSI: U13.42 (PE12)
DN_SPI4_SCK: U13.44 (PE14)
DN_SWCLK: R31.1, U13.76 (PA14(JTCK)
DN_SWDIO: R32.1, U13.72 (PA13(JTMS)
DN_USART1_RX: J4.06, U13.69 (PA10)
DN_USART1_TX: J4.04, U13.68 (PA9)
DN_USART2_RX: U13.25 (PA3); also elsewhere on the board
DN_USART2_TX: U13.24 (PA2); also elsewhere on the board
DefAil: U13.22 (PA0); also elsewhere on the board
DefProf: U13.15 (PC0); also elsewhere on the board
DefRud: U13.16 (PC1); also elsewhere on the board
GND: C26.1, C27.2, C43.2, C47.2, C48.2, C49.2, C50.2, C51.2, C52.2, C59.2, C60.2, C61.2, C62.2, C63.2, C64.2, C65.2, C66.2, J4.07, J4.08, J5.6 (VSS), J5.9 (GND_1), J5.10 (GND_2), J5.11 (GND_3), J5.12 (GND_4), R34.2, R35.2, R36.2, R57.1, R58.1, R59.1, R60.1, R61.1, SW5.2, U13.10 (VSS), U13.19 (VSSA), U13.26 (VSS), U13.49 (VSS), U13.74 (VSS), U13.99 (VSS); also elsewhere on the board
ICM20948_CS: U13.38 (PE8); also elsewhere on the board
MS5611_CS: U13.39 (PE9); also elsewhere on the board
Mic: U13.35 (PB1); also elsewhere on the board
unnamed: C61.1, U13.48 (VCAP)
unnamed: C62.1, U13.73 (VCAP)
unnamed: D11.1 (K), R57.2
unnamed: D12.1 (K), R58.2
unnamed: D13.1 (K), R59.2
unnamed: D14.1 (K), R60.2
unnamed: D15.1 (K), R61.2
unnamed: J4.03, R31.2
unnamed: J4.05, R32.2
unnamed: C59.1, U13.8 (PC14), Y6.1
unnamed: C60.1, U13.9 (PC15), Y6.2
unnamed: C63.1, U13.12 (PH0), Y7.2
unnamed: C64.1, U13.13 (PH1), Y7.1
unnamed: C65.1, C66.1, FB6.2, U13.20 (VREF+), U13.21 (VDDA)
STG1: U13.23 (PA1); also elsewhere on the board
WarmUP_mode_OP: U13.41 (PE11); also elsewhere on the board
pitot: U13.33 (PC5); also elsewhere on the board

Notes on the sheet:
ConfigMode
LEDs
Power
SW Debug & Serial

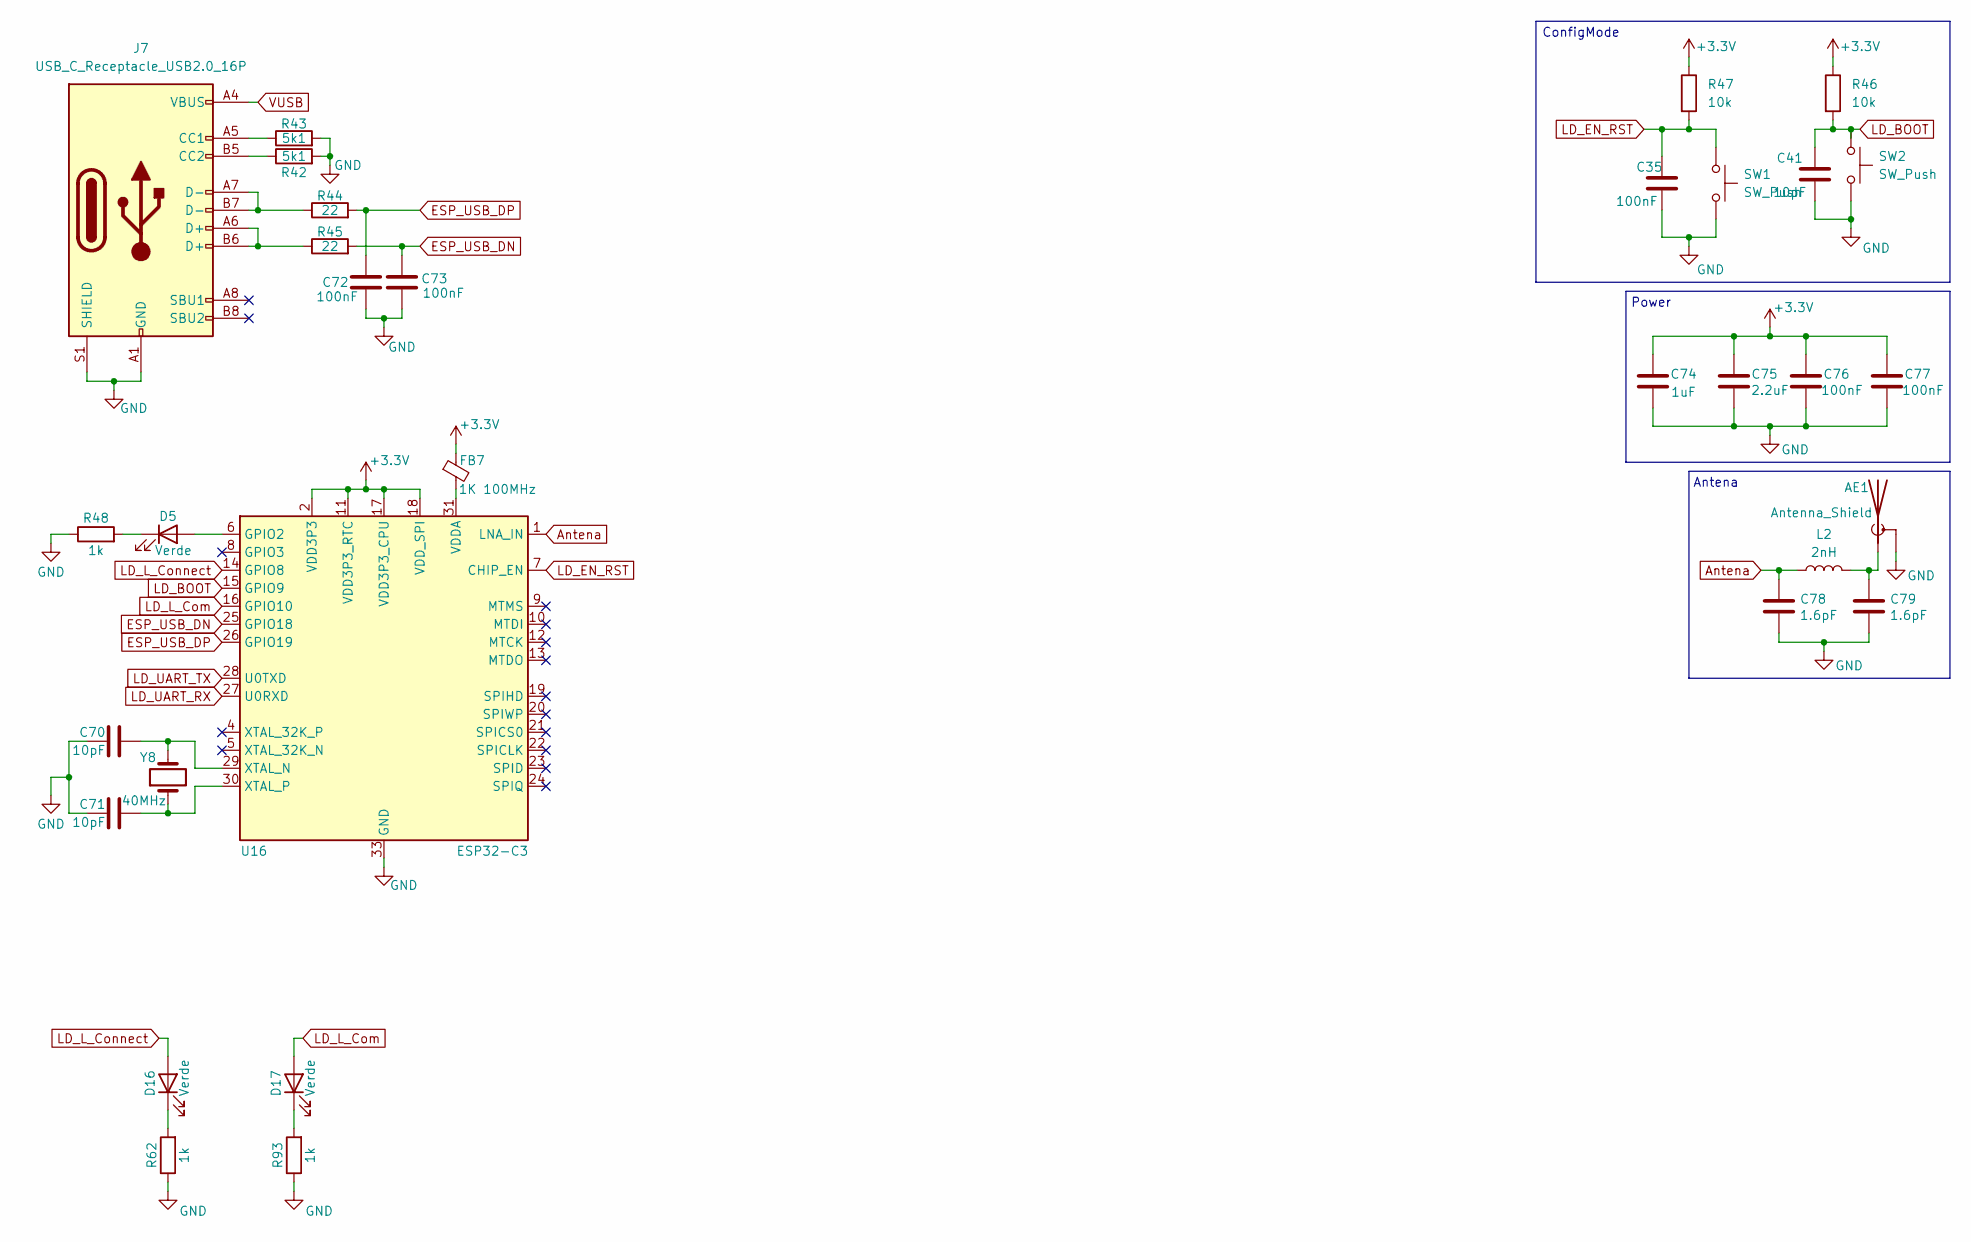
[picture p42: schematic LDIN.kicad_sch, AlarisV1]

Parts:
AE1: Antenna_Shield
C35, C72, C73, C76, C77: 100nF; C_0603_1608Metric_Pad1.08x0.95mm_HandSolder
C41, C70, C71: 10pF; C_0603_1608Metric_Pad1.08x0.95mm_HandSolder
C74: 1uF; C_0603_1608Metric_Pad1.08x0.95mm_HandSolder
C75: 2.2uF; C_0603_1608Metric_Pad1.08x0.95mm_HandSolder
C78, C79: 1.6pF; C_0603_1608Metric_Pad1.08x0.95mm_HandSolder
D5, D16, D17: Verde; LED_0603_1608Metric_Pad1.05x0.95mm_HandSolder
FB7: 1K 100MHz; C_0603_1608Metric_Pad1.08x0.95mm_HandSolder
J7: USB_C_Receptacle_USB2.0_16P; USB_C_Receptacle_G-Switch_GT-USB-7010ASV
L2: 2nH; L_0603_1608Metric_Pad1.05x0.95mm_HandSolder
R42, R43: 5k1; R_0603_1608Metric_Pad0.98x0.95mm_HandSolder
R44, R45: 22; R_0603_1608Metric_Pad0.98x0.95mm_HandSolder
R46, R47: 10k; R_0603_1608Metric_Pad0.98x0.95mm_HandSolder
R48, R62, R93: 1k; R_0603_1608Metric_Pad0.98x0.95mm_HandSolder
SW1, SW2: SW_Push; SKRK
U16: ESP32-C3; QFN-32-1EP_5x5mm_P0.5mm_EP3.7x3.7mm
Y8: 40MHz; Crystal_SMD_3225-4Pin_3.2x2.5mm

Connections:
+3.3V: C74.1, C75.1, C76.1, C77.1, FB7.1, R46.1, R47.1, U16.2 (VDD3P3), U16.3 (VDD3P3), U16.11 (VDD3P3_RTC), U16.17 (VDD3P3_CPU), U16.18 (VDD_SPI); also elsewhere on the board
Antena: C78.1, L2.1, U16.1 (LNA_IN)
ESP_USB_DN: C73.1, R45.2, U16.25 (GPIO18)
ESP_USB_DP: C72.1, R44.2, U16.26 (GPIO19)
GND: AE1.2 (Shield), C35.1, C41.1, C70.2, C71.2, C72.2, C73.2, C74.2, C75.2, C76.2, C77.2, C78.2, C79.2, J7.A1 (GND), J7.A12 (GND), J7.B1 (GND), J7.B12 (GND), J7.S1 (SHIELD), R42.2, R43.2, R48.1, R62.1, R93.1, SW1.2, SW2.2, U16.33 (GND); also elsewhere on the board
LD_BOOT: C41.2, R46.2, SW2.1, U16.15 (GPIO9)
LD_EN_RST: C35.2, R47.2, SW1.1, U16.7 (CHIP_EN)
LD_L_Com: D17.2 (A), U16.16 (GPIO10)
LD_L_Connect: D16.2 (A), U16.14 (GPIO8)
unnamed: AE1.1 (A), C79.1, L2.2
unnamed: D5.2 (A), U16.6 (GPIO2)
unnamed: D5.1 (K), R48.2
unnamed: D16.1 (K), R62.2
unnamed: D17.1 (K), R93.2
unnamed: FB7.2, U16.31 (VDDA), U16.32 (VDDA)
unnamed: J7.A5 (CC1), R43.1
unnamed: J7.B5 (CC2), R42.1
unnamed: J7.A6 (D+), J7.B6 (D+), R45.1
unnamed: J7.A7 (D-), J7.B7 (D-), R44.1
unnamed: C70.1, U16.29 (XTAL_N), Y8.2
unnamed: C71.1, U16.30 (XTAL_P), Y8.1
VUSB: J7.A4 (VBUS), J7.A9 (VBUS), J7.B4 (VBUS), J7.B9 (VBUS)

Notes on the sheet:
Power
Antena
ConfigMode

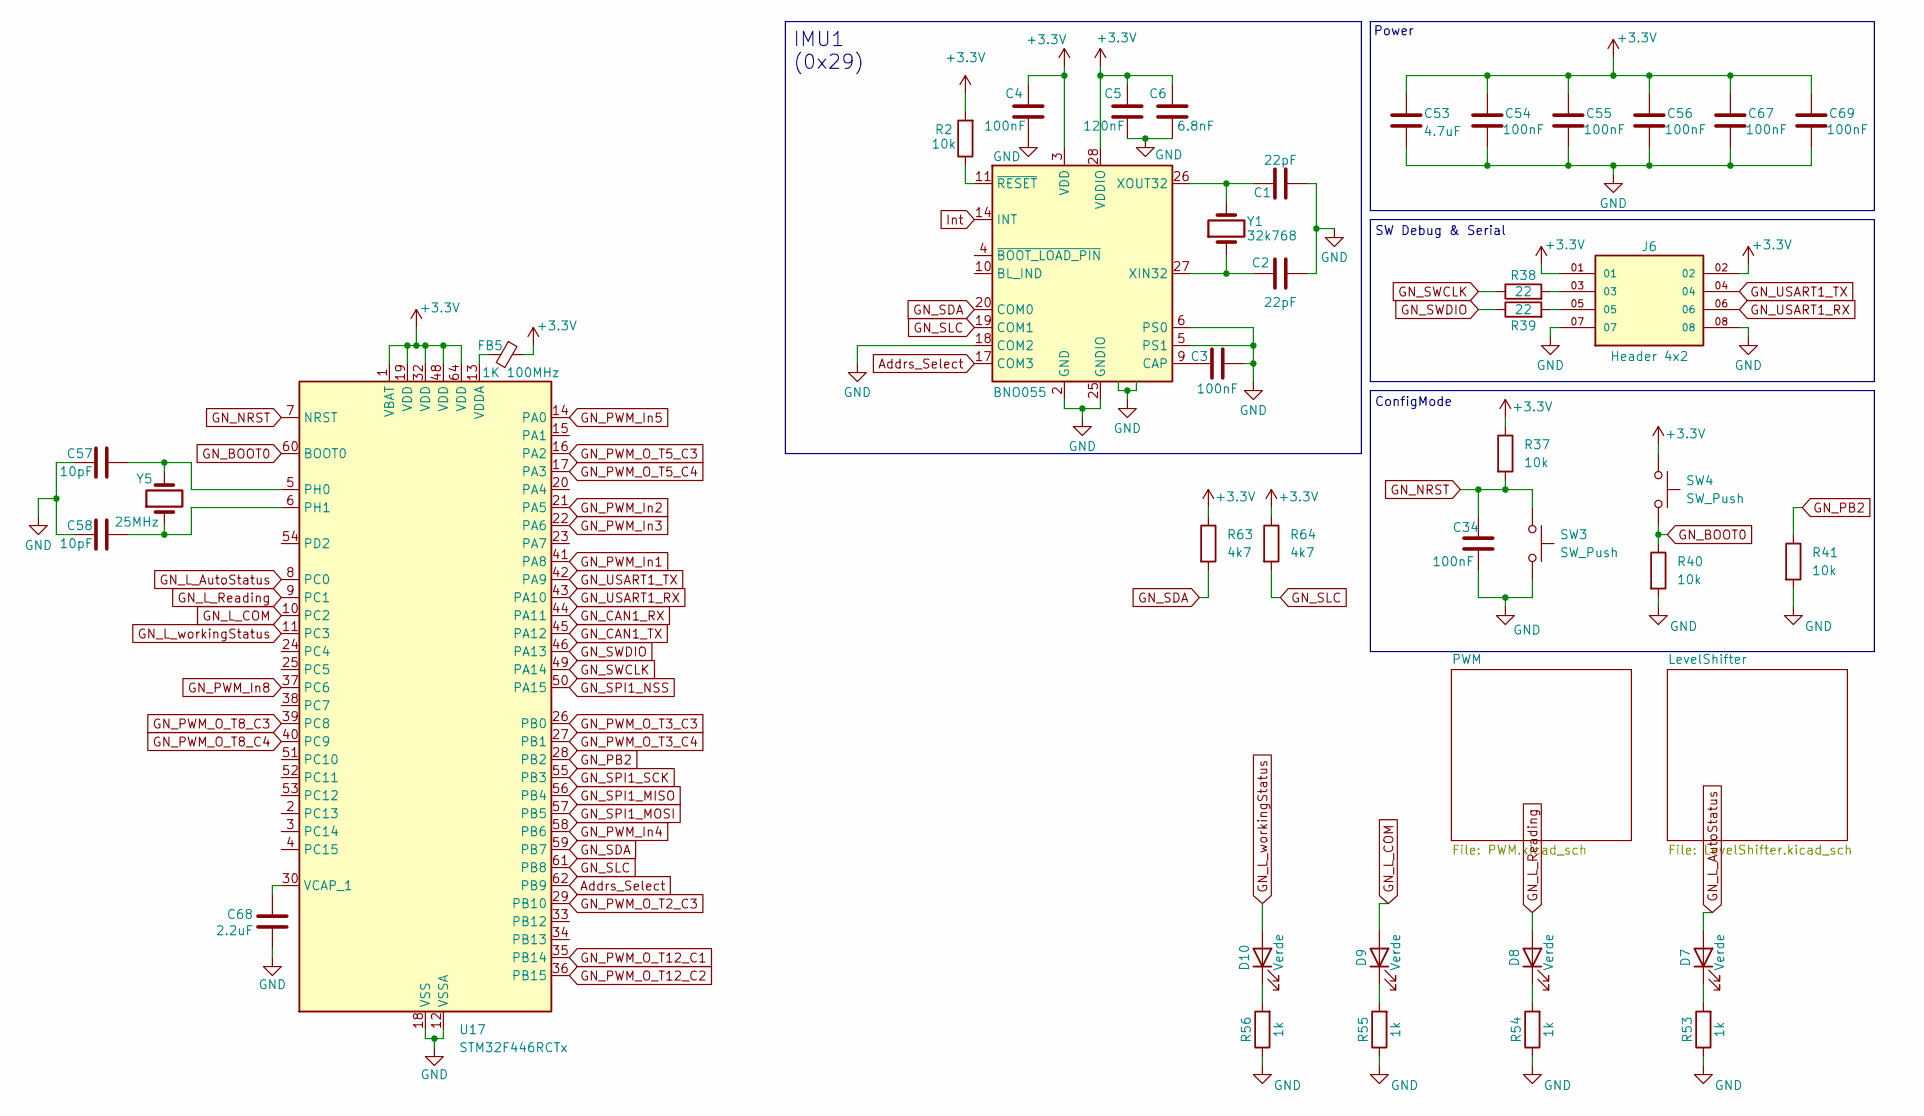
[picture p43: schematic GNCN.kicad_sch, AlarisV1]

Parts:
C1, C2: 22pF; C_0603_1608Metric_Pad1.08x0.95mm_HandSolder
C3, C4, C34, C54, C55, C56, C67, C69: 100nF; C_0603_1608Metric_Pad1.08x0.95mm_HandSolder
C5: 120nF; C_0603_1608Metric_Pad1.08x0.95mm_HandSolder
C6: 6.8nF; C_0603_1608Metric_Pad1.08x0.95mm_HandSolder
C53: 4.7uF; C_0603_1608Metric_Pad1.08x0.95mm_HandSolder
C57, C58: 10pF; C_0603_1608Metric_Pad1.08x0.95mm_HandSolder
C68: 2.2uF; C_0603_1608Metric_Pad1.08x0.95mm_HandSolder
D7, D8, D9, D10: Verde; LED_0603_1608Metric_Pad1.05x0.95mm_HandSolder
FB5: 1K 100MHz; C_0603_1608Metric_Pad1.08x0.95mm_HandSolder
J6: Header 4x2; Header4x2; PARTREV R
R2, R37, R40, R41: 10k; R_0603_1608Metric_Pad0.98x0.95mm_HandSolder
R38, R39: 22; R_0603_1608Metric_Pad0.98x0.95mm_HandSolder
R53, R54, R55, R56: 1k; R_0603_1608Metric_Pad0.98x0.95mm_HandSolder
R63, R64: 4k7; R_0603_1608Metric_Pad0.98x0.95mm_HandSolder
SW3, SW4: SW_Push; SKRK
U2: BNO055; LGA-28_5.2x3.8mm_P0.5mm
U17: STM32F446RCTx; LQFP-64_10x10mm_P0.5mm
Y1: 32k768; Crystal_SMD_3215-2Pin_3.2x1.5mm
Y5: 25MHz; Crystal_SMD_3225-4Pin_3.2x2.5mm

Connections:
+3.3V: C4.1, C5.1, C6.1, C53.1, C54.1, C55.1, C56.1, C67.1, C69.1, FB5.1, J6.01, J6.02, R2.2, R37.1, R63.1, R64.1, SW4.1, U2.3 (VDD), U2.28 (VDDIO), U17.1 (VBAT), U17.19 (VDD), U17.32 (VDD), U17.48 (VDD), U17.64 (VDD); also elsewhere on the board
Addrs_Select: U2.17 (COM3), U17.62 (PB9)
GND: C1.2, C2.2, C3.2, C4.2, C5.2, C6.2, C34.1, C53.2, C54.2, C55.2, C56.2, C57.2, C58.2, C67.2, C68.2, C69.2, J6.07, J6.08, R40.2, R41.2, R53.1, R54.1, R55.1, R56.1, SW3.2, U2.2 (GND), U2.5 (PS1), U2.6 (PS0), U2.15 (PIN15), U2.16 (PIN16), U2.18 (COM2), U2.25 (GNDIO), U17.12 (VSSA), U17.18 (VSS), U17.31 (VSS), U17.47 (VSS), U17.63 (VSS); also elsewhere on the board
GN_BOOT0: R40.1, SW4.2, U17.60 (BOOT0)
GN_CAN1_RX: U17.44 (PA11)
GN_CAN1_TX: U17.45 (PA12)
GN_L_AutoStatus: D7.2 (A), U17.8 (PC0)
GN_L_COM: D9.2 (A), U17.10 (PC2)
GN_L_Reading: D8.2 (A), U17.9 (PC1)
GN_L_workingStatus: D10.2 (A), U17.11 (PC3)
GN_NRST: C34.2, R37.2, SW3.1, U17.7 (NRST)
GN_PB2: R41.1, U17.28 (PB2)
GN_PWM_In1: U17.41 (PA8); also elsewhere on the board
GN_PWM_In2: U17.21 (PA5); also elsewhere on the board
GN_PWM_In3: U17.22 (PA6); also elsewhere on the board
GN_PWM_In4: U17.58 (PB6); also elsewhere on the board
GN_PWM_In5: U17.14 (PA0); also elsewhere on the board
GN_PWM_In8: U17.37 (PC6); also elsewhere on the board
GN_PWM_O_T2_C3: U17.29 (PB10); also elsewhere on the board
GN_PWM_O_T3_C3: U17.26 (PB0); also elsewhere on the board
GN_PWM_O_T3_C4: U17.27 (PB1); also elsewhere on the board
GN_PWM_O_T5_C3: U17.16 (PA2)
GN_PWM_O_T5_C4: U17.17 (PA3); also elsewhere on the board
GN_PWM_O_T8_C3: U17.39 (PC8); also elsewhere on the board
GN_PWM_O_T8_C4: U17.40 (PC9); also elsewhere on the board
GN_PWM_O_T12_C1: U17.35 (PB14); also elsewhere on the board
GN_PWM_O_T12_C2: U17.36 (PB15); also elsewhere on the board
GN_SDA: R63.2, U2.20 (COM0), U17.59 (PB7)
GN_SLC: R64.2, U2.19 (COM1), U17.61 (PB8)
GN_SWCLK: R38.1, U17.49 (PA14)
GN_SWDIO: R39.1, U17.46 (PA13)
GN_USART1_RX: J6.06, U17.43 (PA10)
GN_USART1_TX: J6.04, U17.42 (PA9)
Int: U2.14 (INT)
unnamed: D7.1 (K), R53.2
unnamed: D8.1 (K), R54.2
unnamed: D9.1 (K), R55.2
unnamed: D10.1 (K), R56.2
unnamed: J6.03, R38.2
unnamed: J6.05, R39.2
unnamed: C3.1, U2.9 (CAP)
unnamed: C2.1, U2.27 (XIN32), Y1.1
unnamed: C1.1, U2.26 (XOUT32), Y1.2
unnamed: R2.1, U2.11 (~RESET)
unnamed: C57.1, U17.5 (PH0), Y5.2
unnamed: C58.1, U17.6 (PH1), Y5.1
unnamed: C68.1, U17.30 (VCAP_1)
unnamed: FB5.2, U17.13 (VDDA)

Notes on the sheet:
SW Debug & Serial
Power
ConfigMode
IMU1 (0x29)

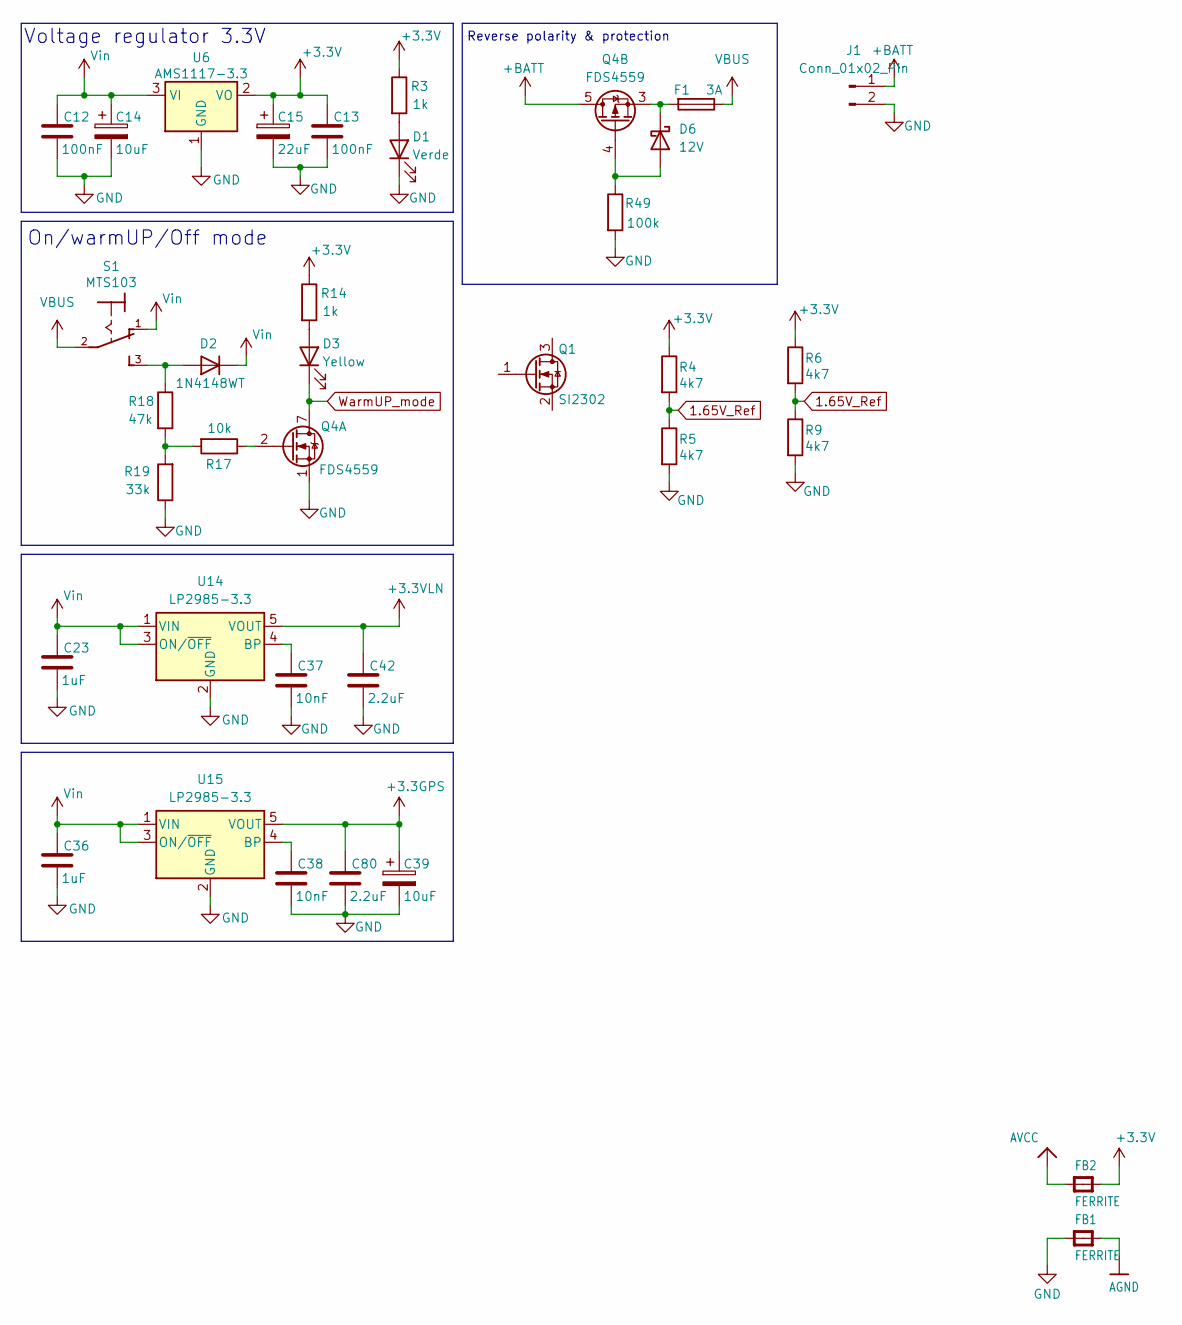
[picture p44: schematic PSN.kicad_sch, AlarisV1]

Parts:
C12, C13: 100nF; C_0603_1608Metric_Pad1.08x0.95mm_HandSolder
C14, C39: 10uF; CP_EIA-3216-18_Kemet-A_Pad1.58x1.35mm_HandSolder
C15: 22uF; CP_EIA-3216-18_Kemet-A_Pad1.58x1.35mm_HandSolder
C23, C36: 1uF; C_0603_1608Metric_Pad1.08x0.95mm_HandSolder
C37, C38: 10nF; C_0603_1608Metric_Pad1.08x0.95mm_HandSolder
C42, C80: 2.2uF; C_0603_1608Metric_Pad1.08x0.95mm_HandSolder
D1: Verde; LED_0603_1608Metric_Pad1.05x0.95mm_HandSolder
D2: 1N4148WT; D_SOD-523
D3: Yellow; LED_0603_1608Metric_Pad1.05x0.95mm_HandSolder
D6: 12V; D_0603_1608Metric_Pad1.05x0.95mm_HandSolder
F1: 3A; Fuse_0603_1608Metric_Pad1.05x0.95mm_HandSolder
FB1, FB2: FERRITE; C_0603_1608Metric_Pad1.08x0.95mm_HandSolder
J1: Conn_01x02_Pin; JST_EH_B2B-EH-A_1x02_P2.50mm_Vertical
Q1: SI2302
Q4: FDS4559; SOIC-8_3.9x4.9mm_P1.27mm
R3, R14: 1k; R_0603_1608Metric_Pad0.98x0.95mm_HandSolder
R4, R5, R6, R9: 4k7; R_0603_1608Metric_Pad0.98x0.95mm_HandSolder
R17: 10k; R_0603_1608Metric_Pad0.98x0.95mm_HandSolder
R18: 47k; R_0603_1608Metric_Pad0.98x0.95mm_HandSolder
R19: 33k; R_0603_1608Metric_Pad0.98x0.95mm_HandSolder
R49: 100k; R_0603_1608Metric_Pad0.98x0.95mm_HandSolder
S1: MTS103
U6: AMS1117-3.3; SOT-223-3_TabPin2
U14, U15: LP2985-3.3; SOT-23-5

Connections:
1.65V_Ref: R4.2, R5.1, R6.2, R9.1; also elsewhere on the board
+3.3GPS: C39.1, C80.1, U15.5 (VOUT); also elsewhere on the board
+3.3V: C13.1, C15.1, FB2.2, R3.1, R4.1, R6.1, R14.1, U6.2 (VO); also elsewhere on the board
+3.3VLN: C42.1, U14.5 (VOUT); also elsewhere on the board
+BATT: J1.1, Q4.5 (D), Q4.6 (D)
AGND: FB1.2; also elsewhere on the board
AVCC: FB2.1; also elsewhere on the board
GND: C12.2, C13.2, C14.2, C15.2, C23.2, C36.2, C37.2, C38.2, C39.2, C42.2, C80.2, D1.1 (K), FB1.1, J1.2, Q4.1 (S), R5.2, R9.2, R19.1, R49.2, U6.1 (GND), U14.2 (GND), U15.2 (GND); also elsewhere on the board
unnamed: D1.2 (A), R3.2
unnamed: D2.2 (A), R18.1, S1.3
unnamed: D3.2 (A), R14.2
unnamed: D6.2 (A), Q4.4 (G), R49.1
unnamed: D6.1 (K), F1.2, Q4.3 (1)
unnamed: Q4.2 (G), R17.1
unnamed: R17.2, R18.2, R19.2
unnamed: C37.1, U14.4 (BP)
unnamed: C38.1, U15.4 (BP)
VBUS: F1.1, S1.2
Vin: C12.1, C14.1, C23.1, C36.1, D2.1 (K), S1.1, U6.3 (VI), U14.1 (VIN), U14.3 (ON/~OFF), U15.1 (VIN), U15.3 (ON/~OFF); also elsewhere on the board
WarmUP_mode: D3.1 (K), Q4.7 (D), Q4.8 (D); also elsewhere on the board

Notes on the sheet:
Voltage regulator 3.3V
On/warmUP/Off mode
Reverse polarity & protection

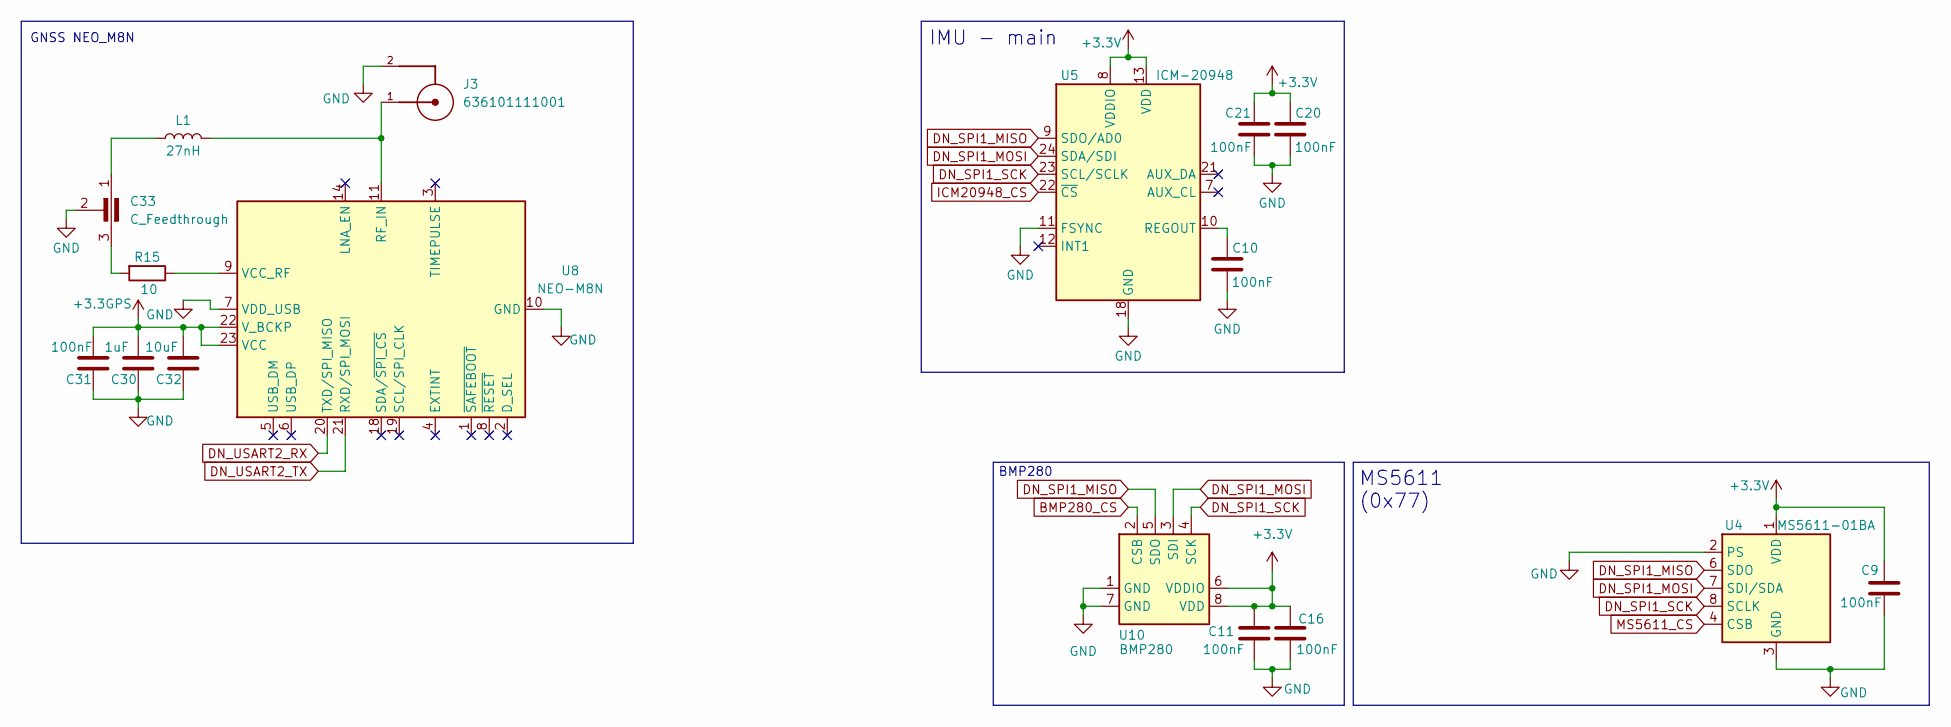
[picture p45: schematic DDA.kicad_sch, AlarisV1]

Parts:
C9, C10, C11, C16, C20, C21, C31: 100nF; C_0603_1608Metric_Pad1.08x0.95mm_HandSolder
C30: 1uF; C_0603_1608Metric_Pad1.08x0.95mm_HandSolder
C32: 10uF; C_0603_1608Metric_Pad1.08x0.95mm_HandSolder
C33: C_Feedthrough
J3: 636101111001
L1: 27nH; L_0603_1608Metric_Pad1.05x0.95mm_HandSolder
R15: 10; R_0603_1608Metric_Pad0.98x0.95mm_HandSolder
U4: MS5611-01BA; LGA-8_3x5mm_P1.25mm
U5: ICM-20948; InvenSense_QFN-24_3x3mm_P0.4mm
U8: NEO-M8N; ublox_NEO
U10: BMP280; Bosch_LGA-8_2x2.5mm_P0.65mm_ClockwisePinNumbering

Connections:
+3.3GPS: C30.2, C31.2, C32.2, U8.22 (V_BCKP), U8.23 (VCC); also elsewhere on the board
+3.3V: C9.1, C11.1, C16.1, C20.1, C21.2, U4.1 (VDD), U5.8 (VDDIO), U5.13 (VDD), U10.6 (VDDIO), U10.8 (VDD); also elsewhere on the board
BMP280_CS: U10.2 (CSB); also elsewhere on the board
DN_SPI1_MISO: U4.6 (SDO), U5.9 (SDO/AD0), U10.5 (SDO); also elsewhere on the board
DN_SPI1_MOSI: U4.7 (SDI/SDA), U5.24 (SDA/SDI), U10.3 (SDI); also elsewhere on the board
DN_SPI1_SCK: U4.8 (SCLK), U5.23 (SCL/SCLK), U10.4 (SCK); also elsewhere on the board
DN_USART2_RX: U8.20 (TXD/SPI_MISO); also elsewhere on the board
DN_USART2_TX: U8.21 (RXD/SPI_MOSI); also elsewhere on the board
GND: C9.2, C10.2, C11.2, C16.2, C20.2, C21.1, C30.1, C31.1, C32.1, C33.2, J3.2, J3.3, U4.2 (PS), U4.3 (GND), U5.11 (FSYNC), U5.18 (GND), U5.20 (GND), U8.7 (VDD_USB), U8.10 (GND), U8.12 (GND), U8.13 (GND), U8.24 (GND), U10.1 (GND), U10.7 (GND); also elsewhere on the board
ICM20948_CS: U5.22 (~CS); also elsewhere on the board
MS5611_CS: U4.4 (CSB), U4.5 (CSB); also elsewhere on the board
unnamed: C33.1, L1.1
unnamed: C33.3, R15.2
unnamed: C10.1, U5.10 (REGOUT)
unnamed: J3.1, L1.2, U8.11 (RF_IN)
unnamed: R15.1, U8.9 (VCC_RF)

Notes on the sheet:
BMP280
MS5611 (0x77)
GNSS NEO_M8N
IMU - main
