EnCl4/Alaris/Alaris - Hardware/AlarisV1.0/AlarisV1.0.kicad_pcb

## KiCad design Alaris - Hardware/AlarisV1.0/AlarisV1.0.kicad_pcb (continued)

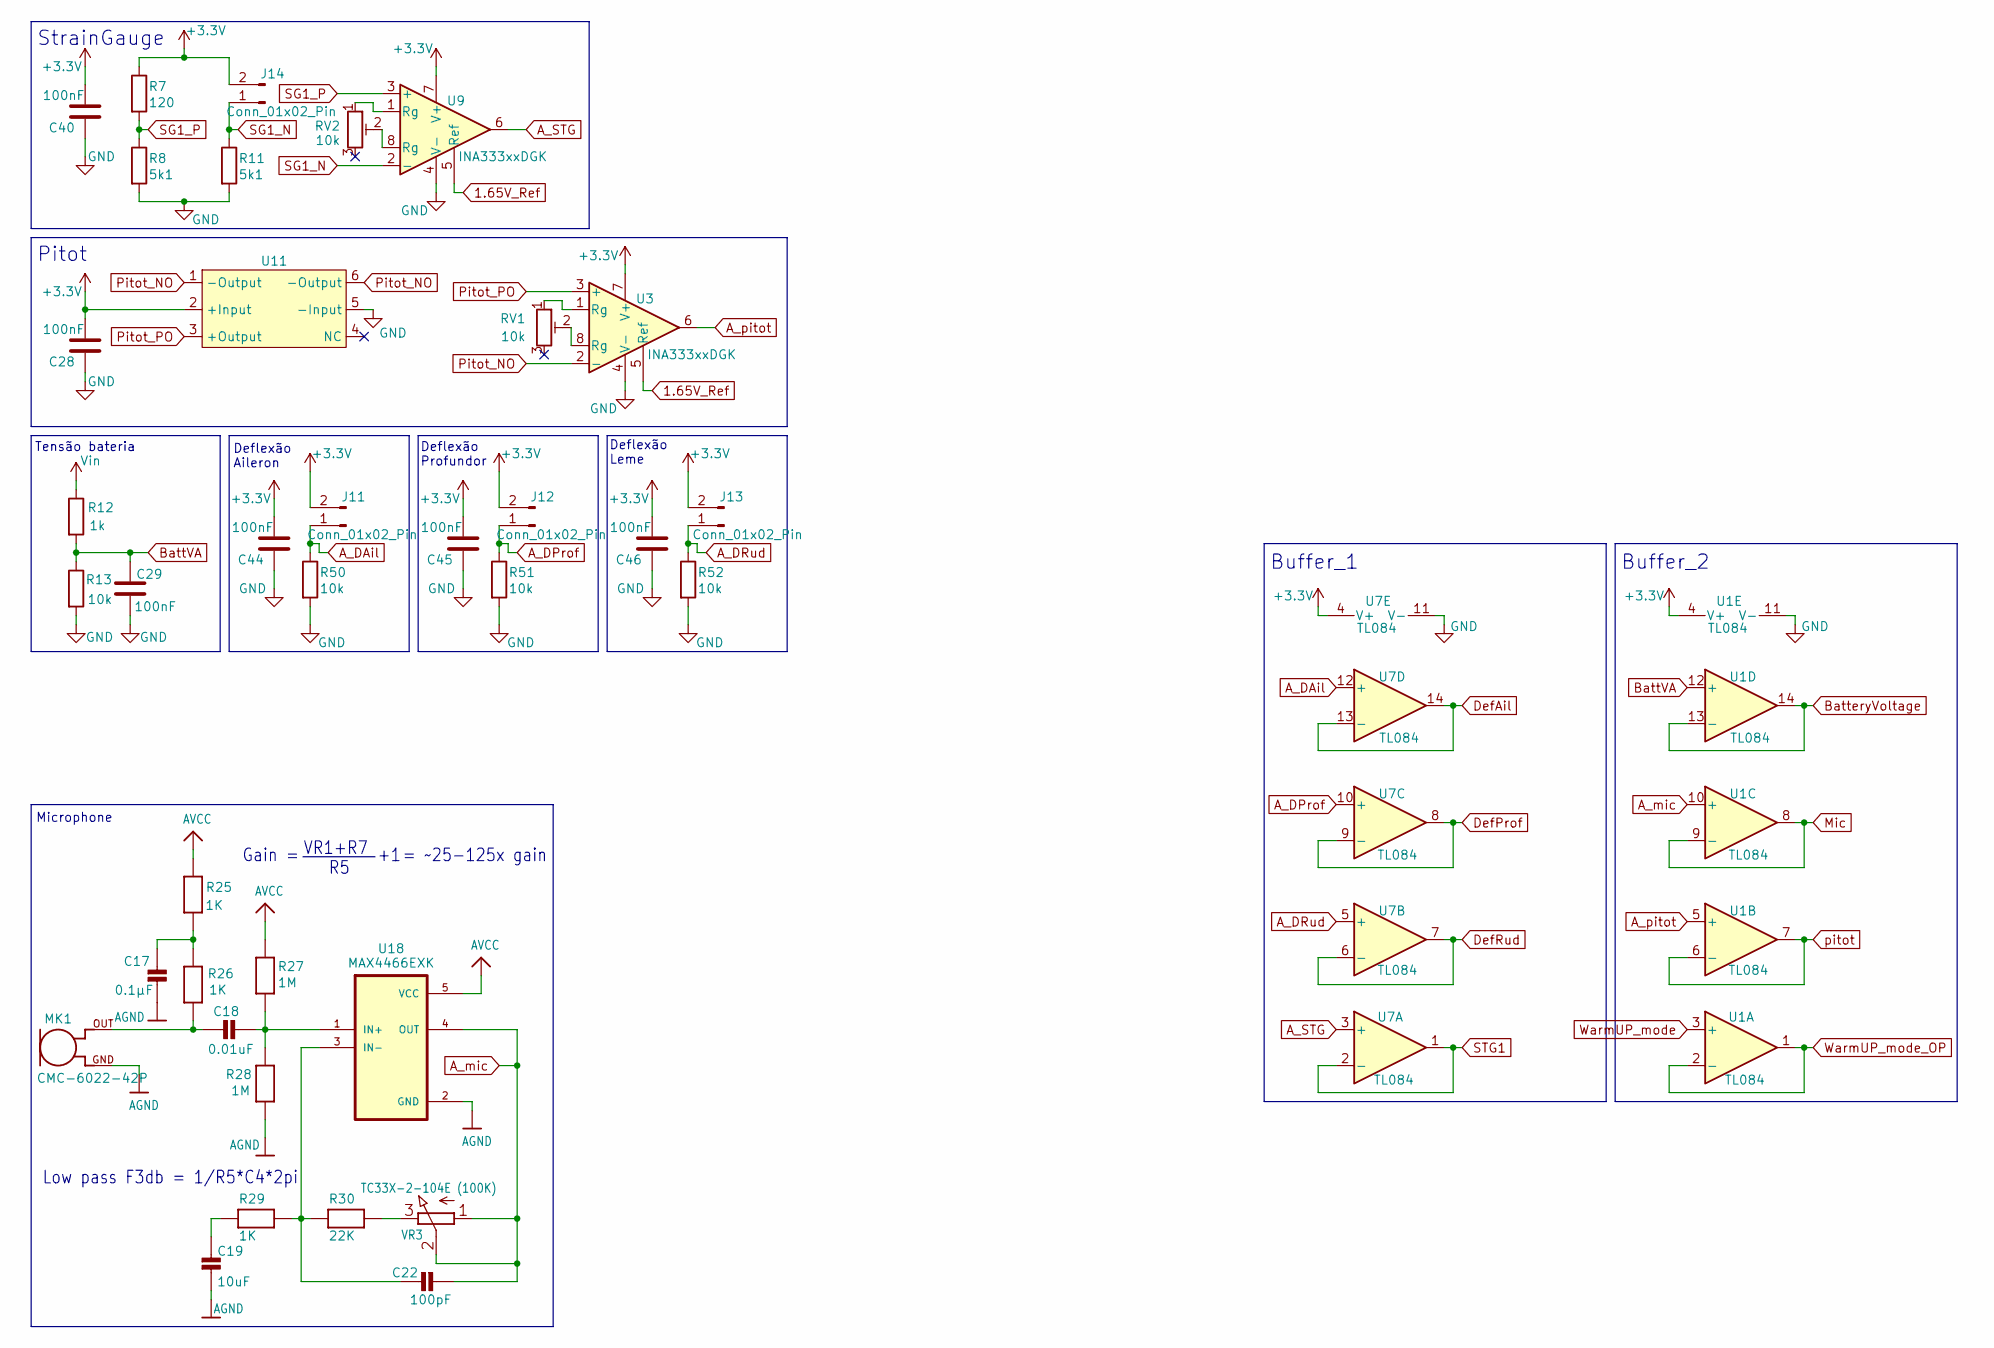
[picture p46: schematic ADA.kicad_sch, AlarisV1]

Parts:
C17: 0.1µF; C_0603_1608Metric_Pad1.08x0.95mm_HandSolder
C18: 0.01uF; C_0603_1608Metric_Pad1.08x0.95mm_HandSolder
C19: 10uF; C_0603_1608Metric_Pad1.08x0.95mm_HandSolder
C22: 100pF; C_0603_1608Metric_Pad1.08x0.95mm_HandSolder
C28, C29, C40, C44, C45, C46: 100nF; C_0603_1608Metric_Pad1.08x0.95mm_HandSolder
J11, J12, J13, J14: Conn_01x02_Pin; JST_EH_B2B-EH-A_1x02_P2.50mm_Vertical
MK1: CMC-6022-42P; Mic6022; PARTREV 1
R7: 120; R_0603_1608Metric_Pad0.98x0.95mm_HandSolder
R8, R11: 5k1; R_0603_1608Metric_Pad0.98x0.95mm_HandSolder
R12: 1k; R_0603_1608Metric_Pad0.98x0.95mm_HandSolder
R13, R50, R51, R52: 10k; R_0603_1608Metric_Pad0.98x0.95mm_HandSolder
R25, R26, R29: 1K; R_0603_1608Metric_Pad0.98x0.95mm_HandSolder
R27, R28: 1M; R_0603_1608Metric_Pad0.98x0.95mm_HandSolder
R30: 22K; R_0603_1608Metric_Pad0.98x0.95mm_HandSolder
RV1, RV2: 10k; Potentiometer_Bourns_TC33X_Vertical
U1, U7: TL084; SOIC-14_3.9x8.7mm_P1.27mm
U3, U9: INA333xxDGK; VSSOP-8_3x3mm_P0.65mm
U11: MPS20N0040D
U18: MAX4466EXK; MAX4466
VR3: TC33X-2-104E (100K); Potentiometer_Bourns_TC33X_Vertical

Connections:
1.65V_Ref: U3.5 (Ref), U9.5 (Ref); also elsewhere on the board
+3.3V: C28.2, C40.2, C44.2, C45.2, C46.2, J11.2, J12.2, J13.2, J14.2, R7.1, U1.4 (V+), U3.7 (V+), U7.4 (V+), U9.7 (V+), U11.2 (+Input); also elsewhere on the board
AGND: C17.2, C19.2, MK1.GND, R28.1, U18.2 (GND); also elsewhere on the board
AVCC: R25.2, R27.2, U18.5 (VCC); also elsewhere on the board
A_DAil: J11.1, R50.1, U7.12 (+)
A_DProf: J12.1, R51.1, U7.10 (+)
A_DRud: J13.1, R52.1, U7.5 (+)
A_STG: U7.3 (+), U9.6
A_mic: C22.1, U1.10 (+), U18.4 (OUT), VR3.1 (A), VR3.2 (S)
A_pitot: U1.5 (+), U3.6
BattVA: C29.1, R12.2, R13.1, U1.12 (+)
BatteryVoltage: U1.13 (-), U1.14; also elsewhere on the board
DefAil: U7.13 (-), U7.14; also elsewhere on the board
DefProf: U7.8, U7.9 (-); also elsewhere on the board
DefRud: U7.6 (-), U7.7; also elsewhere on the board
GND: C28.1, C29.2, C40.1, C44.1, C45.1, C46.1, R8.2, R11.2, R13.2, R50.2, R51.2, R52.2, U1.11 (V-), U3.4 (V-), U7.11 (V-), U9.4 (V-), U11.5 (-Input); also elsewhere on the board
Mic: U1.8, U1.9 (-); also elsewhere on the board
unnamed: C17.1, R25.1, R26.2
unnamed: C18.1, MK1.OUT, R26.1
unnamed: C18.2, R27.1, R28.2, U18.1 (IN+)
unnamed: C19.1, R29.1
unnamed: C22.2, R29.2, R30.1, U18.3 (IN-)
unnamed: RV1.1, U3.1 (Rg)
unnamed: RV1.2, U3.8 (Rg)
unnamed: RV2.1, U9.1 (Rg)
unnamed: RV2.2, U9.8 (Rg)
unnamed: R30.2, VR3.3 (E)
Pitot_NO: U3.2 (-), U11.1 (-Output), U11.6 (-Output)
Pitot_PO: U3.3 (+), U11.3 (+Output)
SG1_N: J14.1, R11.1, U9.2 (-)
SG1_P: R7.2, R8.1, U9.3 (+)
STG1: U7.1, U7.2 (-); also elsewhere on the board
Vin: R12.1; also elsewhere on the board
WarmUP_mode: U1.3 (+); also elsewhere on the board
WarmUP_mode_OP: U1.1, U1.2 (-); also elsewhere on the board
pitot: U1.6 (-), U1.7; also elsewhere on the board

Notes on the sheet:
Tensão bateria
StrainGauge
Deflexão Aileron
Microphone
Buffer_1
Deflexão Leme
Gain =
Buffer_2
Low pass F3db = 1/R5*C4*2pi
Deflexão Profundor
VR1+R7
Pitot
= ~25-125x gain

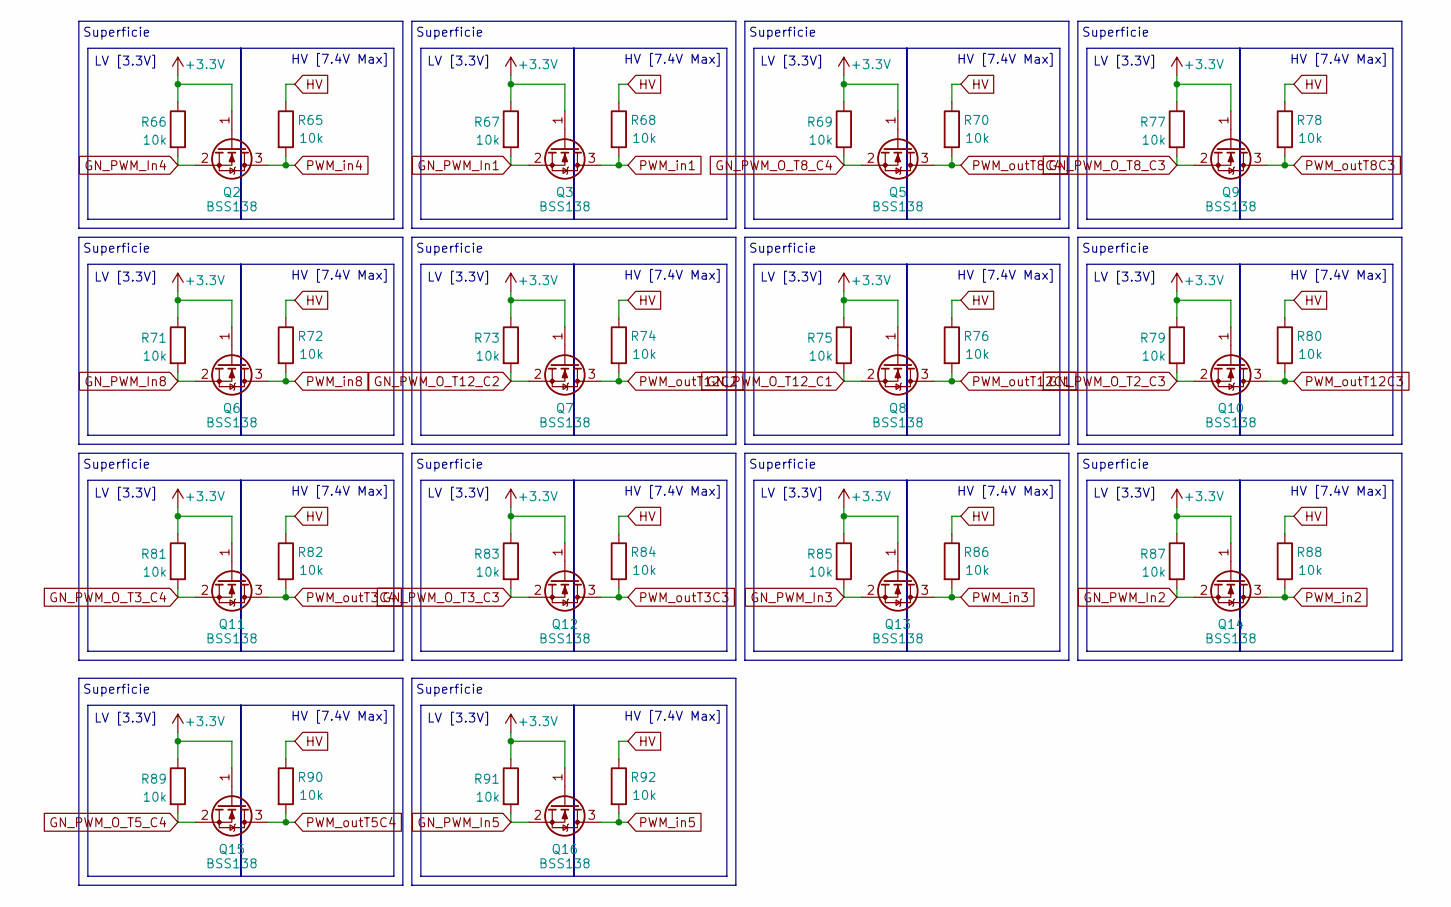
[picture p47: schematic LevelShifter.kicad_sch, AlarisV1]

Parts:
Q2, Q3, Q5, Q6, Q7, Q8, Q9, Q10, Q11, Q12, Q13, Q14, Q15, Q16: BSS138; SOT-23
R65, R66, R67, R68, R69, R70, R71, R72, R73, R74, R75, R76, R77, R78, R79, R80, R81, R82, R83, R84, R85, R86, R87, R88, R89, R90, R91, R92: 10k; R_0603_1608Metric_Pad0.98x0.95mm_HandSolder

Connections:
+3.3V: Q2.1 (G), Q3.1 (G), Q5.1 (G), Q6.1 (G), Q7.1 (G), Q8.1 (G), Q9.1 (G), Q10.1 (G), Q11.1 (G), Q12.1 (G), Q13.1 (G), Q14.1 (G), Q15.1 (G), Q16.1 (G), R66.1, R67.1, R69.1, R71.1, R73.1, R75.1, R77.1, R79.1, R81.1, R83.1, R85.1, R87.1, R89.1, R91.1; also elsewhere on the board
GN_PWM_In1: Q3.2 (S), R67.2; also elsewhere on the board
GN_PWM_In2: Q14.2 (S), R87.2; also elsewhere on the board
GN_PWM_In3: Q13.2 (S), R85.2; also elsewhere on the board
GN_PWM_In4: Q2.2 (S), R66.2; also elsewhere on the board
GN_PWM_In5: Q16.2 (S), R91.2; also elsewhere on the board
GN_PWM_In8: Q6.2 (S), R71.2; also elsewhere on the board
GN_PWM_O_T2_C3: Q10.2 (S), R79.2; also elsewhere on the board
GN_PWM_O_T3_C3: Q12.2 (S), R83.2; also elsewhere on the board
GN_PWM_O_T3_C4: Q11.2 (S), R81.2; also elsewhere on the board
GN_PWM_O_T5_C4: Q15.2 (S), R89.2; also elsewhere on the board
GN_PWM_O_T8_C3: Q9.2 (S), R77.2; also elsewhere on the board
GN_PWM_O_T8_C4: Q5.2 (S), R69.2; also elsewhere on the board
GN_PWM_O_T12_C1: Q8.2 (S), R75.2; also elsewhere on the board
GN_PWM_O_T12_C2: Q7.2 (S), R73.2; also elsewhere on the board
HV: R65.1, R68.1, R70.1, R72.1, R74.1, R76.1, R78.1, R80.1, R82.1, R84.1, R86.1, R88.1, R90.1, R92.1; also elsewhere on the board
PWM_in1: Q3.3 (D), R68.2; also elsewhere on the board
PWM_in2: Q14.3 (D), R88.2; also elsewhere on the board
PWM_in3: Q13.3 (D), R86.2; also elsewhere on the board
PWM_in4: Q2.3 (D), R65.2; also elsewhere on the board
PWM_in5: Q16.3 (D), R92.2; also elsewhere on the board
PWM_in8: Q6.3 (D), R72.2; also elsewhere on the board
PWM_outT3C3: Q12.3 (D), R84.2; also elsewhere on the board
PWM_outT3C4: Q11.3 (D), R82.2; also elsewhere on the board
PWM_outT5C4: Q15.3 (D), R90.2; also elsewhere on the board
PWM_outT8C3: Q9.3 (D), R78.2; also elsewhere on the board
PWM_outT8C4: Q5.3 (D), R70.2; also elsewhere on the board
PWM_outT12C1: Q8.3 (D), R76.2; also elsewhere on the board
PWM_outT12C2: Q7.3 (D), R74.2; also elsewhere on the board
PWM_outT12C3: Q10.3 (D), R80.2; also elsewhere on the board

Notes on the sheet:
HV [7.4V Max]
LV [3.3V]
Superficie

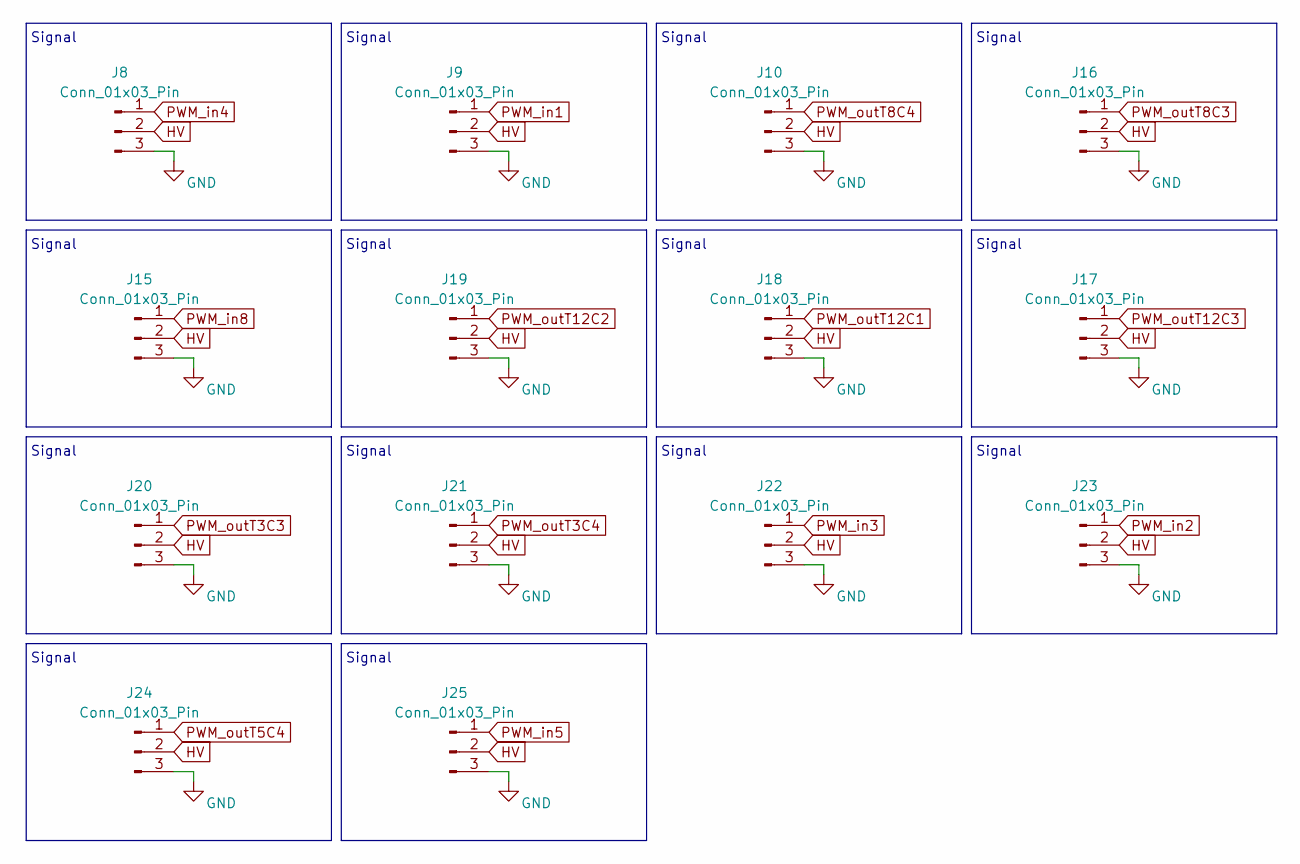
[picture p48: schematic PWM.kicad_sch, AlarisV1]

Parts:
J8, J9, J10, J15, J16, J17, J18, J19, J20, J21, J22, J23, J24, J25: Conn_01x03_Pin; JST_EH_B3B-EH-A_1x03_P2.50mm_Vertical

Connections:
GND: J8.3, J9.3, J10.3, J15.3, J16.3, J17.3, J18.3, J19.3, J20.3, J21.3, J22.3, J23.3, J24.3, J25.3; also elsewhere on the board
HV: J8.2, J9.2, J10.2, J15.2, J16.2, J17.2, J18.2, J19.2, J20.2, J21.2, J22.2, J23.2, J24.2, J25.2; also elsewhere on the board
PWM_in1: J9.1; also elsewhere on the board
PWM_in2: J23.1; also elsewhere on the board
PWM_in3: J22.1; also elsewhere on the board
PWM_in4: J8.1; also elsewhere on the board
PWM_in5: J25.1; also elsewhere on the board
PWM_in8: J15.1; also elsewhere on the board
PWM_outT3C3: J20.1; also elsewhere on the board
PWM_outT3C4: J21.1; also elsewhere on the board
PWM_outT5C4: J24.1; also elsewhere on the board
PWM_outT8C3: J16.1; also elsewhere on the board
PWM_outT8C4: J10.1; also elsewhere on the board
PWM_outT12C1: J18.1; also elsewhere on the board
PWM_outT12C2: J19.1; also elsewhere on the board
PWM_outT12C3: J17.1; also elsewhere on the board

Notes on the sheet:
Signal

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
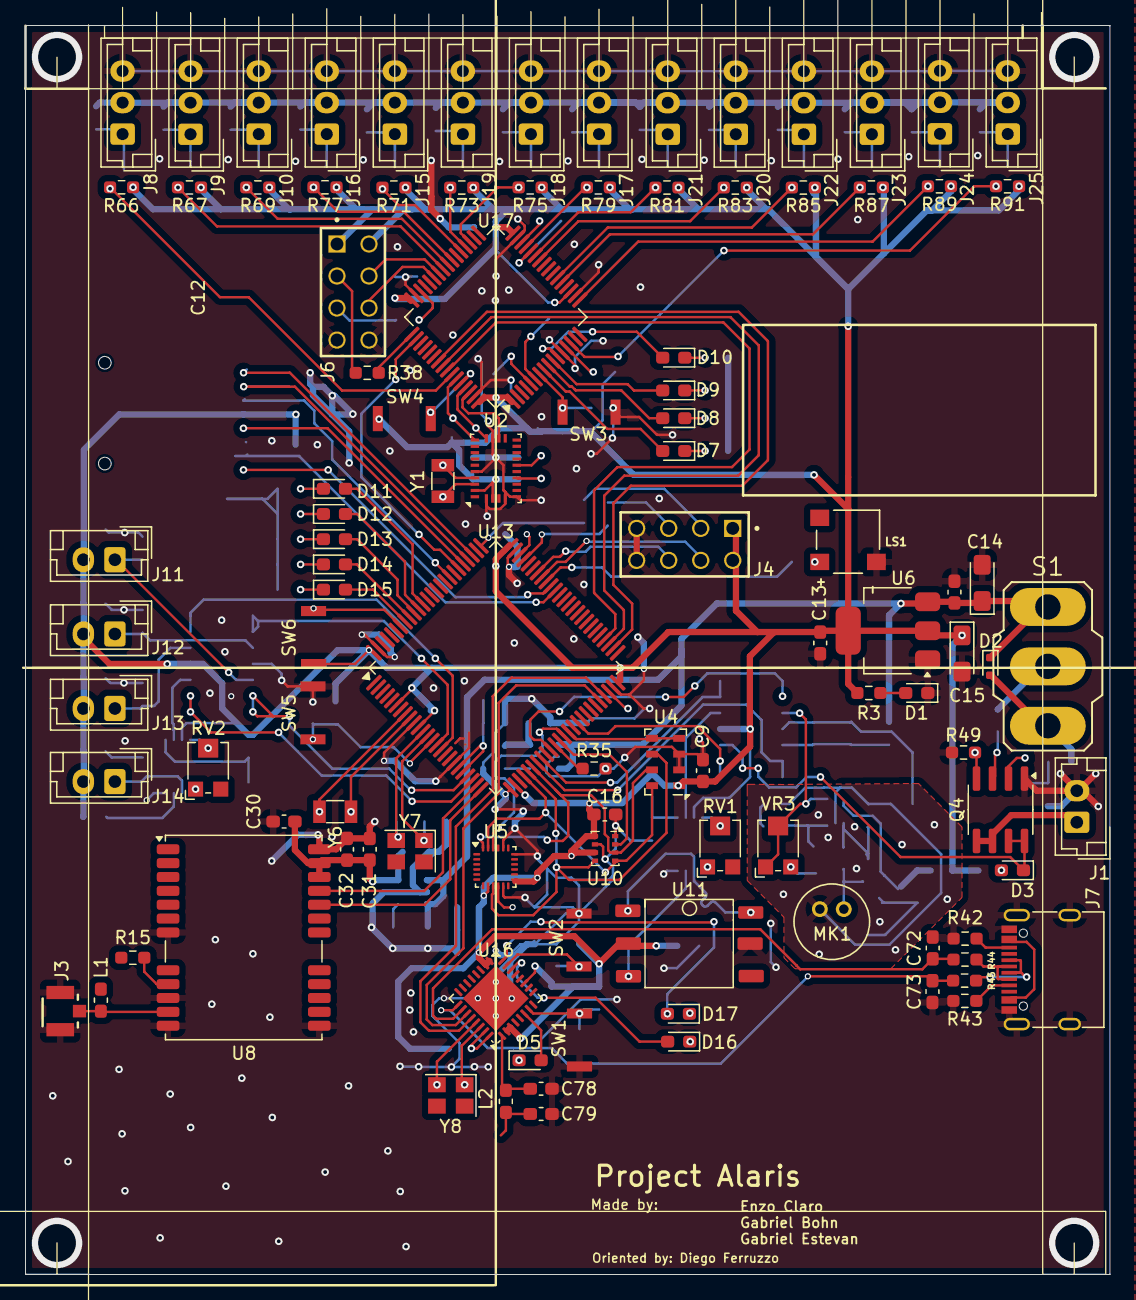
[picture p49: board AlarisV1.0.kicad_pcb from above]

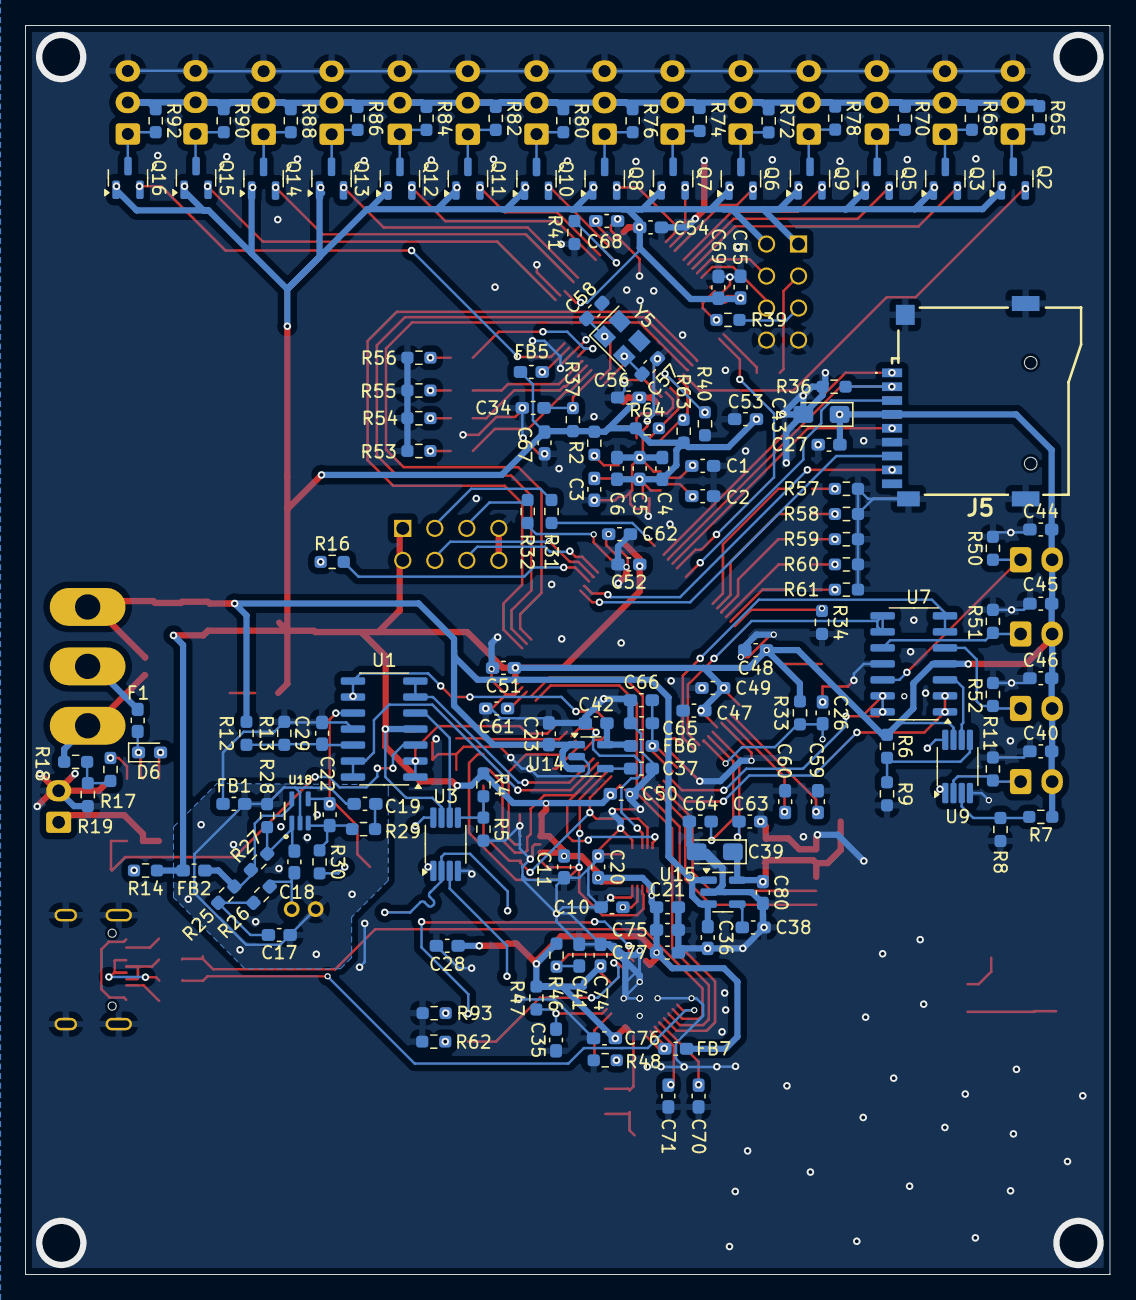
[picture p50: board AlarisV1.0.kicad_pcb from below]

Board: 2 copper layers, 86.0 x 99.1 mm, 258 parts (155 on the bottom side), 177 nets.
