EnCl4/Alaris/Software/New/DAPU/IndividualCodes/bmp280/BMP280_SPI_main.c

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
/* Includes ------------------------------------------------------------------*/
#include "main.h"

/* USER CODE BEGIN Includes */
#include <stdio.h>
#include <math.h>
/* USER CODE END Includes */

SPI_HandleTypeDef hspi2;

UART_HandleTypeDef huart1;

void SystemClock_Config(void);
static void MX_GPIO_Init(void);
static void MX_USART1_UART_Init(void);
static void MX_SPI2_Init(void);
/* USER CODE BEGIN 0 */
int _write(int file, char *ptr, int len)
{
    HAL_UART_Transmit(&huart1, (uint8_t *)ptr, len, HAL_MAX_DELAY);
    return len;
}
#define BMP280_CS_PORT GPIOB
#define BMP280_CS_PIN GPIO_PIN_2


#define BMP280_REG_ID 0xD0
#define BMP280_REG_RESET 0xE0
#define BMP280_REG_STATUS 0xF3
#define BMP280_REG_CTRL_MEAS 0xF4
#define BMP280_REG_CONFIG 0xF5
#define BMP280_REG_PRESS_MSB 0xF7
#define BMP280_REG_TEMP_MSB 0xFA
#define BMP280_REG_CALIB00 0x88

#define BMP280_RESET_VALUE 0xB6

static uint16_t dig_T1;
static int16_t dig_T2, dig_T3;
static uint16_t dig_P1;
static int16_t dig_P2, dig_P3, dig_P4, dig_P5, dig_P6, dig_P7, dig_P8, dig_P9;

static int32_t t_fine;

static void BMP280_CS_Low(void) { HAL_GPIO_WritePin(BMP280_CS_PORT, BMP280_CS_PIN, GPIO_PIN_RESET); }
static void BMP280_CS_High(void) { HAL_GPIO_WritePin(BMP280_CS_PORT, BMP280_CS_PIN, GPIO_PIN_SET); }

static void BMP280_SPI_Read(uint8_t reg, uint8_t *buf, uint16_t len)
{
uint8_t addr = reg | 0x80; // MSB=1 for read
BMP280_CS_Low();
HAL_SPI_Transmit(&hspi2, &addr, 1, HAL_MAX_DELAY);
HAL_SPI_Receive(&hspi2, buf, len, HAL_MAX_DELAY);
BMP280_CS_High();
}

static void BMP280_SPI_Write(uint8_t reg, uint8_t data)
{
uint8_t buf[2];
buf[0] = reg & 0x7F; // MSB=0 for write
buf[1] = data;
BMP280_CS_Low();
HAL_SPI_Transmit(&hspi2, buf, 2, HAL_MAX_DELAY);
BMP280_CS_High();
}


static uint8_t BMP280_Read8(uint8_t reg)
{
uint8_t val;
BMP280_SPI_Read(reg, &val, 1);
return val;
};

static void BMP280_ReadCalibration(void)
{
uint8_t calib[24];
BMP280_SPI_Read(BMP280_REG_CALIB00, calib, 24);


dig_T1 = (uint16_t)(calib[1] << 8 | calib[0]);
dig_T2 = (int16_t)(calib[3] << 8 | calib[2]);
dig_T3 = (int16_t)(calib[5] << 8 | calib[4]);


dig_P1 = (uint16_t)(calib[7] << 8 | calib[6]);
dig_P2 = (int16_t)(calib[9] << 8 | calib[8]);
dig_P3 = (int16_t)(calib[11] << 8 | calib[10]);
dig_P4 = (int16_t)(calib[13] << 8 | calib[12]);
dig_P5 = (int16_t)(calib[15] << 8 | calib[14]);
dig_P6 = (int16_t)(calib[17] << 8 | calib[16]);
dig_P7 = (int16_t)(calib[19] << 8 | calib[18]);
dig_P8 = (int16_t)(calib[21] << 8 | calib[20]);
dig_P9 = (int16_t)(calib[23] << 8 | calib[22]);
}

uint8_t BMP280_Init(void)
{
uint8_t id = BMP280_Read8(BMP280_REG_ID);
if (id != 0x58) return 0; // BMP280 chip ID


// Soft reset
BMP280_SPI_Write(BMP280_REG_RESET, BMP280_RESET_VALUE);
HAL_Delay(10);


BMP280_ReadCalibration();


// Config: standby 1000 ms, filter off
BMP280_SPI_Write(BMP280_REG_CONFIG, (5 << 5) | (0 << 2));


// Ctrl_meas: temp oversampling x2, press oversampling x16, normal mode
BMP280_SPI_Write(BMP280_REG_CTRL_MEAS, (2 << 5) | (5 << 2) | 3);


return 1;
};

static int32_t BMP280_ReadRawTemp(void)
{
uint8_t buf[3];
BMP280_SPI_Read(BMP280_REG_TEMP_MSB, buf, 3);
return (int32_t)((buf[0] << 12) | (buf[1] << 4) | (buf[2] >> 4));
};

static int32_t BMP280_ReadRawPress(void){
uint8_t buf[3];
BMP280_SPI_Read(BMP280_REG_PRESS_MSB, buf, 3);
return (int32_t)((buf[0] << 12) | (buf[1] << 4) | (buf[2] >> 4));
};


float BMP280_ReadTemperature(void)
{
int32_t adc_T = BMP280_ReadRawTemp();


int32_t var1 = ((((adc_T >> 3) - ((int32_t)dig_T1 << 1))) * ((int32_t)dig_T2)) >> 11;
int32_t var2 = (((((adc_T >> 4) - ((int32_t)dig_T1)) * ((adc_T >> 4) - ((int32_t)dig_T1))) >> 12) * ((int32_t)dig_T3)) >> 14;


t_fine = var1 + var2;


float T = (t_fine * 5 + 128) >> 8;
return T / 100.0f;
};


float BMP280_ReadPressure(void)
{
int32_t adc_P = BMP280_ReadRawPress();


int64_t var1 = ((int64_t)t_fine) - 128000;
int64_t var2 = var1 * var1 * (int64_t)dig_P6;
var2 = var2 + ((var1 * (int64_t)dig_P5) << 17);
var2 = var2 + (((int64_t)dig_P4) << 35);
var1 = ((var1 * var1 * (int64_t)dig_P3) >> 8) + ((var1 * (int64_t)dig_P2) << 12);
var1 = (((((int64_t)1) << 47) + var1)) * ((int64_t)dig_P1) >> 33;


if (var1 == 0) return 0; // avoid exception


int64_t p = 1048576 - adc_P;
p = (((p << 31) - var2) * 3125) / var1;
var1 = (((int64_t)dig_P9) * (p >> 13) * (p >> 13)) >> 25;
var2 = (((int64_t)dig_P8) * p) >> 19;


p = ((p + var1 + var2) >> 8) + (((int64_t)dig_P7) << 4);


return (float)p / 256.0f; // Pa
};


float BMP280_ComputeAltitude(float pressure_pa, float sea_level_pa)
{
return 44330.0f * (1.0f - powf(pressure_pa / sea_level_pa, 0.1903f));
};


// Example usage in main loop
void BMP280_Task(float *temperature, float *pressure, float *altitude)
{
    *temperature = BMP280_ReadTemperature();
    *pressure    = BMP280_ReadPressure();
    *altitude    = BMP280_ComputeAltitude(*pressure, 101325.0f);
}
/* USER CODE END 0 */

/**
  * @brief  The application entry point.
  * @retval int
  */
int main(void)
{

  /* USER CODE BEGIN 1 */
	float te, pr, al;
  /* USER CODE END 1 */

  /* MCU Configuration--------------------------------------------------------*/

  /* Reset of all peripherals, Initializes the Flash interface and the Systick. */
  HAL_Init();

  /* Configure the system clock */
  SystemClock_Config();

  /* Initialize all configured peripherals */
  MX_GPIO_Init();
  MX_USART1_UART_Init();
  MX_SPI2_Init();
  /* USER CODE BEGIN 2 */

  if (!BMP280_Init())
  {
      // Handle error: sensor not detected
  }

  CoreDebug->DEMCR |= CoreDebug_DEMCR_TRCENA_Msk; // Enable trace
  DWT->CYCCNT = 0;                                // Reset counter
  DWT->CTRL |= DWT_CTRL_CYCCNTENA_Msk;            // Enable cycle counter
  /* USER CODE END 2 */

  /* Infinite loop */
  /* USER CODE BEGIN WHILE */
  while (1)
  {
    /* USER CODE END WHILE */

    /* USER CODE BEGIN 3 */

	  uint32_t start_cycles = DWT->CYCCNT;

	  BMP280_Task(&te, &pr, &al);

	  uint32_t end_cycles = DWT->CYCCNT;
	  uint32_t delta_cycles = end_cycles - start_cycles;
	  printf(">T:%.2f\n>P:%.2f\n>Alt:%.2f\r\n", te, pr, al);
	  printf("Ciclos: %lu \n", delta_cycles);
	  float time_us = (float)delta_cycles / 84.0f;
	  printf("Us: %.3f \n", time_us);
	  HAL_Delay(10);



  }
  /* USER CODE END 3 */
}

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
