EnCl4/Alaris/Software/New/DAPU/DAPU.ioc

Mcu.UserName=STM32H723VGTx
PA0.Signal=ADC1_INP16
PA1.Signal=ADC1_INP17
PA10.Signal=USART1_RX
PA13(JTMS/SWDIO).Signal=DEBUG_JTMS-SWDIO
PA14(JTCK/SWCLK).Signal=DEBUG_JTCK-SWCLK
PA2.Signal=USART2_TX
PA3.Signal=GPIO_Analog
PA5.Signal=SPI1_SCK
PA6.Signal=SPI1_MISO
PA7.Signal=SPI1_MOSI
PA8.GPIO_Label=Buzzer
PA8.Signal=GPIO_Output
PA9.Signal=USART1_TX
PB0.Signal=GPIO_Analog
PB1.Signal=ADCx_INP5
PB10.Signal=USART3_TX
PB11.Signal=USART3_RX
PB13.Signal=SPI2_SCK
PB14.Signal=SPI2_MISO
PB15.Signal=SPI2_MOSI
PB3(JTDO/TRACESWO).GPIO_Label=LED_RUN
PB3(JTDO/TRACESWO).Signal=GPIO_Output
PB4(NJTRST).GPIO_Label=LED_SENSORS
PB4(NJTRST).Signal=GPIO_Output
PB5.GPIO_Label=LED_SD
PB5.Signal=GPIO_Output
PB6.GPIO_Label=LED_GNCU
PB6.Signal=GPIO_Output
PB7.GPIO_Label=LED_CGU
PB7.Signal=GPIO_Output
PB8.Signal=I2C1_SCL
PB9.Signal=I2C1_SDA
PC0.Signal=ADCx_INP10
PC1.Signal=ADCx_INP11
PC10.Signal=SDMMC1_D2
PC11.Signal=SDMMC1_D3
PC12.Signal=SDMMC1_CK
PC14-OSC32_IN.Signal=RCC_OSC32_IN
PC15-OSC32_OUT.Signal=RCC_OSC32_OUT
PC4.Signal=ADCx_INP4
PC5.Signal=ADCx_INP8
PC8.Signal=SDMMC1_D0
PC9.Signal=SDMMC1_D1
PD0.Signal=GPIO_Output
PD2.Signal=SDMMC1_CMD
PD6.Signal=USART2_RX
PE10.GPIO_Label=L_workingStatus
PE10.Signal=GPIO_Output
PE11.Signal=GPIO_Input
PE12.Signal=SPI4_SCK
PE14.Signal=SPI4_MOSI
PE2.Signal=GPIO_Output
PE3.GPIO_Label=LED_BOARD
PE3.Signal=GPIO_Output
PE4.Signal=GPIO_Output
PE7.GPIO_Label=BMP280_CS
PE7.Signal=GPIO_Output
PE8.GPIO_Label=ICM20948_CS
PE8.Signal=GPIO_Output
PE9.GPIO_Label=MS5611_CS
PE9.Signal=GPIO_Output
PH0-OSC_IN.Signal=RCC_OSC_IN
PH1-OSC_OUT.Signal=RCC_OSC_OUT
