EnCl4/Alaris/Software/New/GNCN/Core/Src/main.c

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
/* Includes ------------------------------------------------------------------*/
#include "main.h"
#include "cmsis_os.h"
#include "i2c.h"
#include "spi.h"
#include "tim.h"
#include "usart.h"
#include "gpio.h"

/* USER CODE BEGIN Includes */
#include <stdlib.h>
#include <stdio.h>
#include <stdbool.h>
/* USER CODE END Includes */


/* USER CODE BEGIN PV */
uint8_t rx_data[8];
uint8_t tx_data[8];  // response (optional)

uint8_t counter = 0;

uint16_t x = 0;
uint16_t y = 0;
uint16_t z = 0;

uint8_t flags = 0;
uint8_t checksum = 0;

// ---- 3. Validate checksum ----
uint8_t calc = 0;
bool connected = 0;

void HAL_SPI_TxRxCpltCallback(SPI_HandleTypeDef *hspi)
{
	if (hspi->Instance == SPI1)
    {
        // ---- 1. Validate header ----
    	//HAL_GPIO_TogglePin(GPIOC, GPIO_PIN_7);




            // ---- 2. Extract data ----
            counter = rx_data[1];

            x = (rx_data[2] << 8) | rx_data[3];
            y = (rx_data[4] << 8) | rx_data[5];
            z = (rx_data[6] << 8) | rx_data[7];

            flags = rx_data[8];
            checksum = rx_data[9];

            // ---- 3. Validate checksum ----
            calc = rx_data[0] ^ rx_data[1] ^ rx_data[2] ^ rx_data[3] ^
                           rx_data[4] ^ rx_data[5] ^ rx_data[6] ^ rx_data[7] ^ rx_data[8];

            if (calc != checksum){
            	connected = 0;
            }
            else{
            	connected = 1;
            }
        // ---- 4. Prepare response (optional) ----
        tx_data[0] = 0xB1;  // response header
        tx_data[1] = rx_data[1]; // echo counter (good for sync/debug)

        // ---- 5. RE-ARM SPI (CRITICAL) ----
        HAL_SPI_TransmitReceive_IT(&hspi1, tx_data, rx_data, 10);
    }
}


/* USER CODE END PV */

void SystemClock_Config(void);
void MX_FREERTOS_Init(void);
/* USER CODE BEGIN 0 */

//int _write(int file, char *ptr, int len)
//{
//    HAL_UART_Transmit(&huart1, (uint8_t *)ptr, len, HAL_MAX_DELAY);
//    return len;
//}


//typedef struct
//  {
//      uint32_t pulse_us;
//      uint32_t period_us;
//      float duty;
//
//      uint32_t last_update_tick;
//  } PWM_Channel_t;
//
//
//
//  #define PWM_CHANNELS 6
//  volatile PWM_Channel_t pwm[PWM_CHANNELS];

//  void HAL_TIM_IC_CaptureCallback(TIM_HandleTypeDef *htim)
//  {
//      uint32_t period, pulse;
//
//      if(htim->Channel != HAL_TIM_ACTIVE_CHANNEL_1)
//          return;
//
//      if(htim->Channel == HAL_TIM_ACTIVE_CHANNEL_1)
//      {
//          period = HAL_TIM_ReadCapturedValue(htim, TIM_CHANNEL_1);
//          pulse  = HAL_TIM_ReadCapturedValue(htim, TIM_CHANNEL_2);
//      }
//
//      if(period == 0) return;
//
//      uint8_t idx = 0xFF;
//
//      if(htim->Instance == TIM1) idx = 0;
//      else if(htim->Instance == TIM2) idx = 1;
//      else if(htim->Instance == TIM3) idx = 2;
//      else if(htim->Instance == TIM4) idx = 3;
//      else if(htim->Instance == TIM5) idx = 4;
//      else if(htim->Instance == TIM8) idx = 5;
//
//      if(idx < PWM_CHANNELS)
//      {
//          pwm[idx].pulse_us = pulse;   // assuming prescaler = 1 MHz
//          pwm[idx].period_us = period;
//          pwm[idx].duty = (float)pulse / (float)period;
//          //pwm[idx].last_update_tick = xTaskGetTickCountFromISR();
//      }
//  }



/* USER CODE END 0 */

/**
  * @brief  The application entry point.
  * @retval int
  */
int main(void)
{

  /* MCU Configuration--------------------------------------------------------*/

  /* Reset of all peripherals, Initializes the Flash interface and the Systick. */
  HAL_Init();

  /* USER CODE BEGIN Init */





//  float mapPWM(uint32_t pulse)
//  {
//      // Typical RC: 1000–2000 µs
//      return ((float)pulse - 1500.0f) / 500.0f; // → [-1, 1]
//  }




  /* USER CODE END Init */

  /* Configure the system clock */
  SystemClock_Config();

  /* Initialize all configured peripherals */
  MX_GPIO_Init();
  MX_USART1_UART_Init();
  MX_TIM2_Init();
  MX_TIM3_Init();
  MX_TIM5_Init();
  MX_TIM1_Init();
  MX_TIM4_Init();
  MX_TIM8_Init();
  MX_TIM12_Init();
  MX_I2C1_Init();
  MX_SPI1_Init();
  /* USER CODE BEGIN 2 */

  HAL_SPI_TransmitReceive_IT(&hspi1, tx_data, rx_data, 8);

  /* Start PWM input capture */

  HAL_TIM_IC_Start_IT(&htim1, TIM_CHANNEL_1);

  HAL_TIM_IC_Start_IT(&htim2, TIM_CHANNEL_1);
  HAL_TIM_IC_Start_IT(&htim2, TIM_CHANNEL_2);

  HAL_TIM_IC_Start_IT(&htim3, TIM_CHANNEL_1);
  HAL_TIM_IC_Start_IT(&htim3, TIM_CHANNEL_2);

  HAL_TIM_IC_Start_IT(&htim4, TIM_CHANNEL_1);

  HAL_TIM_IC_Start_IT(&htim5, TIM_CHANNEL_1);
  HAL_TIM_IC_Start_IT(&htim5, TIM_CHANNEL_2);

  HAL_TIM_IC_Start_IT(&htim8, TIM_CHANNEL_1);
  HAL_TIM_IC_Start_IT(&htim8, TIM_CHANNEL_2);

  //Inicialzação dos Emissores de PWM para os servos

  HAL_TIM_PWM_Start(&htim1, TIM_CHANNEL_4);

  HAL_TIM_PWM_Start(&htim2, TIM_CHANNEL_3);
  HAL_TIM_PWM_Start(&htim2, TIM_CHANNEL_4);

  HAL_TIM_PWM_Start(&htim3, TIM_CHANNEL_3);
  HAL_TIM_PWM_Start(&htim3, TIM_CHANNEL_4);

  HAL_TIM_PWM_Start(&htim5, TIM_CHANNEL_3);
  HAL_TIM_PWM_Start(&htim5, TIM_CHANNEL_4);

  HAL_TIM_PWM_Start(&htim8, TIM_CHANNEL_3);
  HAL_TIM_PWM_Start(&htim8, TIM_CHANNEL_4);

  HAL_TIM_PWM_Start(&htim12, TIM_CHANNEL_1);
  HAL_TIM_PWM_Start(&htim12, TIM_CHANNEL_2);

  //HAL_TIM_PWM_Start(&htim5, TIM_CHANNEL_3);

  //__HAL_TIM_SET_COMPARE(&htim3, TIM_CHANNEL_3, 910);


  CoreDebug->DEMCR |= CoreDebug_DEMCR_TRCENA_Msk; // Enable trace
  DWT->CYCCNT = 0;                                // Reset counter
  DWT->CTRL |= DWT_CTRL_CYCCNTENA_Msk;            // Enable cycle counter

  /* USER CODE END 2 */

  /* Init scheduler */
  osKernelInitialize();  /* Call init function for freertos objects (in cmsis_os2.c) */
  MX_FREERTOS_Init();

  /* Start scheduler */
  osKernelStart();

  /* We should never get here as control is now taken by the scheduler */

  /* Infinite loop */
  /* USER CODE BEGIN WHILE */
  while (1)
  {
    /* USER CODE END WHILE */

    /* USER CODE BEGIN 3 */


  }
  /* USER CODE END 3 */
}

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
