EnCl4/Alaris/Software/New/DAPU/Core/Src/main.c

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
/* Includes ------------------------------------------------------------------*/
#include "main.h"
#include "cmsis_os.h"
#include "adc.h"
#include "dma.h"
#include "fatfs.h"
#include "sdmmc.h"
#include "spi.h"
#include "usart.h"
#include "gpio.h"

/* USER CODE BEGIN Includes */
#include "dapu_state.h"
#include "dapu_config.h"
#include "icm_bus_selftest.h"
#include "i2c.h"
#include "tim.h"
/* USER CODE END Includes */


void SystemClock_Config(void);
static void MPU_Config(void);
void MX_FREERTOS_Init(void);
/* USER CODE BEGIN 0 */
/*
 * Scope of this build: acquisition, processing and SD logging only.
 * The GNCU link (SPI2 + PD0) and the CGU link (USART3) are initialised by
 * CubeMX but deliberately left unused - see DAPU_FIRMWARE_NOTES.md.
 */
/* USER CODE END 0 */

/**
  * @brief  The application entry point.
  * @retval int
  */
int main(void)
{

  /* USER CODE BEGIN 1 */
  /* Runs on the HSI, before anything can fail: three quick flashes here mean
   * "the firmware is executing and reached main()". If PE3 never flashes at
   * all the problem is power, reset or programming - not this code. */
  DAPU_BootLedInit();
  DAPU_BootLedFlash(3);
  /* USER CODE END 1 */

  /* MPU Configuration--------------------------------------------------------*/
  MPU_Config();

  /* MCU Configuration--------------------------------------------------------*/

  /* Reset of all peripherals, Initializes the Flash interface and the Systick. */
  HAL_Init();

  /* Configure the system clock */
  SystemClock_Config();

  /* USER CODE BEGIN SysInit */
  dapu_micros_init();
  /* USER CODE END SysInit */

  /* Initialize all configured peripherals */
  MX_GPIO_Init();
  MX_DMA_Init();
  MX_USART1_UART_Init();
  MX_SPI1_Init();
  MX_SPI2_Init();
  MX_USART2_UART_Init();
  MX_SDMMC1_SD_Init();
  MX_FATFS_Init();
  MX_SPI4_Init();
  MX_USART3_UART_Init();
  MX_ADC1_Init();
  /* USER CODE BEGIN 2 */
  /* TIM2 is maintained by hand, outside CubeMX.
   *
   * It only needs to emit TRGO at 1024 Hz to clock the ADC scan - no pin, no
   * channel, no interrupt - and CubeMX will not accept that as a configured
   * peripheral: every regeneration drops it from the IP list, removes this
   * call and comments HAL_TIM_MODULE_ENABLED back out, leaving tim.c orphaned
   * and the build broken. Keeping the init here (a USER CODE section) and
   * defining HAL_TIM_MODULE_ENABLED in the project settings makes it survive.
   *
   * If you ever do activate TIM2 in the CubeMX GUI, delete this call so it is
   * not initialised twice. */
  MX_TIM2_Init();

#if ICM20948_USE_I2C
  /* I2C1 on PB8/PB9 carries the IMU, after the SPI link to that module could
   * not be made to work.
   *
   * hi2c1 lives in .bss, so Instance is NULL until something initialises it:
   * this call therefore runs only when CubeMX did *not* generate one above.
   * That makes the code correct whether or not I2C1 survives in the .ioc,
   * without any risk of initialising the peripheral twice. */
  if (hi2c1.Instance == NULL)
  {
    MX_I2C1_Init();
  }
#endif

  /* First sign of life: clock tree, GPIO and every peripheral init survived.
   * The LED stays solid through the ~3 s sensor probe and calibration, then
   * starts blinking at 1 Hz once the 200 Hz task is running. */
  HAL_GPIO_WritePin(LED_BOARD_GPIO_Port, LED_BOARD_Pin, LED_BOARD_ON);

#if ICM_BUS_SELFTEST
  /* Bring-up only: proves the SPI link to the ICM20948 with nothing else in
   * the way. Runs here, before the RTOS, so no task, mutex or driver can be
   * blamed for the result. Set ICM_BUS_SELFTEST to 0 in dapu_config.h when
   * the sensor answers. */
  icm_bus_selftest_run();
#endif
  /* USER CODE END 2 */

  /* Init scheduler */
  osKernelInitialize();  /* Call init function for freertos objects (in cmsis_os2.c) */
  MX_FREERTOS_Init();

  /* Start scheduler */
  osKernelStart();

  /* We should never get here as control is now taken by the scheduler */

  /* Infinite loop */
  /* USER CODE BEGIN WHILE */
  while (1)
  {
    /* USER CODE END WHILE */

    /* USER CODE BEGIN 3 */
  }
  /* USER CODE END 3 */
}

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
/* USER CODE BEGIN 4 */
/* Brings PE3 up on its own. Called both from main() before anything else and
 * from DAPU_BlinkForever(), so the blink codes work even when the failure
 * happens before MX_GPIO_Init() has enabled the GPIOE clock - which is where
 * a clock configuration failure lands. */
void DAPU_BootLedInit(void)
{
  GPIO_InitTypeDef GPIO_InitStruct = {0};

  __HAL_RCC_GPIOE_CLK_ENABLE();

  GPIO_InitStruct.Pin = LED_BOARD_Pin;
  GPIO_InitStruct.Mode = GPIO_MODE_OUTPUT_PP;
  GPIO_InitStruct.Pull = GPIO_NOPULL;
  GPIO_InitStruct.Speed = GPIO_SPEED_FREQ_LOW;
  HAL_GPIO_Init(LED_BOARD_GPIO_Port, &GPIO_InitStruct);
}

/* Busy-wait flash burst. Toggling, so it is visible whatever the LED
 * polarity, and usable before SysTick exists. */
void DAPU_BootLedFlash(uint8_t count)
{
  for (uint8_t i = 0; i < count; i++)
  {
    HAL_GPIO_TogglePin(LED_BOARD_GPIO_Port, LED_BOARD_Pin);
    for (volatile uint32_t d = 0; d < 400000u; d++) { __NOP(); }
    HAL_GPIO_TogglePin(LED_BOARD_GPIO_Port, LED_BOARD_Pin);
    for (volatile uint32_t d = 0; d < 400000u; d++) { __NOP(); }
  }
}

void DAPU_BlinkForever(uint8_t pulses)
{
  DAPU_BootLedInit();

  /* Interrupts are usually disabled by the time we get here, so SysTick is
   * dead and HAL_Delay() would never return: busy-wait instead. At 200 MHz
   * these counts give roughly 80 ms on/off and a 500 ms gap between groups. */
  for (;;)
  {
    for (uint8_t i = 0; i < pulses; i++)
    {
      HAL_GPIO_WritePin(LED_BOARD_GPIO_Port, LED_BOARD_Pin, LED_BOARD_ON);
      for (volatile uint32_t d = 0; d < 2000000u; d++) { __NOP(); }
      HAL_GPIO_WritePin(LED_BOARD_GPIO_Port, LED_BOARD_Pin, LED_BOARD_OFF);
      for (volatile uint32_t d = 0; d < 2000000u; d++) { __NOP(); }
    }
    for (volatile uint32_t d = 0; d < 12000000u; d++) { __NOP(); }
  }
}
/* USER CODE END 4 */

 /* MPU Configuration */

void MPU_Config(void)
{
  MPU_Region_InitTypeDef MPU_InitStruct = {0};

  /* Disables the MPU */
  HAL_MPU_Disable();

  /** Initializes and configures the Region and the memory to be protected
  */
  MPU_InitStruct.Enable = MPU_REGION_ENABLE;
  MPU_InitStruct.Number = MPU_REGION_NUMBER0;
  MPU_InitStruct.BaseAddress = 0x0;
  MPU_InitStruct.Size = MPU_REGION_SIZE_4GB;
  MPU_InitStruct.SubRegionDisable = 0x87;
  MPU_InitStruct.TypeExtField = MPU_TEX_LEVEL0;
  MPU_InitStruct.AccessPermission = MPU_REGION_NO_ACCESS;
  MPU_InitStruct.DisableExec = MPU_INSTRUCTION_ACCESS_DISABLE;
  MPU_InitStruct.IsShareable = MPU_ACCESS_SHAREABLE;
  MPU_InitStruct.IsCacheable = MPU_ACCESS_NOT_CACHEABLE;
  MPU_InitStruct.IsBufferable = MPU_ACCESS_NOT_BUFFERABLE;

  HAL_MPU_ConfigRegion(&MPU_InitStruct);
  /* Enables the MPU */
  HAL_MPU_Enable(MPU_PRIVILEGED_DEFAULT);

}

/**
  * @brief  This function is executed in case of error occurrence.
  * @retval None
  */
void Error_Handler(void)
{
  /* USER CODE BEGIN Error_Handler_Debug */
  /* User can add his own implementation to report the HAL error return state */
  __disable_irq();
  /* One blink per group on the on-board LED, so a peripheral that refuses to
   * initialise is visible on the bench instead of looking like a dead board. */
  DAPU_BlinkForever(1);
  /* USER CODE END Error_Handler_Debug */
}
#ifdef USE_FULL_ASSERT
/**
  * @brief  Reports the name of the source file and the source line number
  *         where the assert_param error has occurred.
  * @param  file: pointer to the source file name
  * @param  line: assert_param error line source number
  * @retval None
  */
void assert_failed(uint8_t *file, uint32_t line)
{
  /* USER CODE BEGIN 6 */
  /* User can add his own implementation to report the file name and line number,
     ex: printf("Wrong parameters value: file %s on line %d\r\n", file, line) */
  /* USER CODE END 6 */
}
#endif /* USE_FULL_ASSERT */
