EnCl4/Alaris/Software/New/DAPU/Core/Inc/main.h

#define LED_BOARD_Pin GPIO_PIN_3
#define LED_BOARD_GPIO_Port GPIOE
#define BMP280_CS_Pin GPIO_PIN_7
#define BMP280_CS_GPIO_Port GPIOE
#define ICM20948_CS_Pin GPIO_PIN_8
#define ICM20948_CS_GPIO_Port GPIOE
#define MS5611_CS_Pin GPIO_PIN_9
#define MS5611_CS_GPIO_Port GPIOE
#define L_workingStatus_Pin GPIO_PIN_10
#define L_workingStatus_GPIO_Port GPIOE
#define Buzzer_Pin GPIO_PIN_8
#define Buzzer_GPIO_Port GPIOA
#define LED_RUN_Pin GPIO_PIN_3
#define LED_RUN_GPIO_Port GPIOB
#define LED_SENSORS_Pin GPIO_PIN_4
#define LED_SENSORS_GPIO_Port GPIOB
#define LED_SD_Pin GPIO_PIN_5
#define LED_SD_GPIO_Port GPIOB
#define LED_GNCU_Pin GPIO_PIN_6
#define LED_GNCU_GPIO_Port GPIOB
#define LED_CGU_Pin GPIO_PIN_7
#define LED_CGU_GPIO_Port GPIOB
#define LED_BOARD_ACTIVE_LOW    1
#define LED_BOARD_ON            GPIO_PIN_RESET
#define LED_BOARD_OFF           GPIO_PIN_SET
#define LED_BOARD_ON            GPIO_PIN_SET
#define LED_BOARD_OFF           GPIO_PIN_RESET
