EnCl4/Alaris/BibliotecasSoft/bno055-master-f2738bed38962437c4694702e65aabc566cbee7b/bno055/Src/main.c

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

/* Includes ------------------------------------------------------------------*/
#include "main.h"
#include "dma.h"
#include "i2c.h"
#include "usart.h"
#include "gpio.h"

/* USER CODE BEGIN Includes */
#include "accel.h"
/* USER CODE END Includes */


void SystemClock_Config(void);
/* USER CODE BEGIN PFP */
#ifdef __GNUC__
#define PUTCHAR_PROTOTYPE int __io_putchar(int ch)
#else
#define PUTCHAR_PROTOTYPE int fputc(int ch, FILE *f)
#endif /* __GNUC__ */

PUTCHAR_PROTOTYPE {
        while (HAL_UART_Transmit(&huart2, (uint8_t *)&ch, 1, 10) != HAL_OK) {};
 return ch;
}
/* USER CODE END PFP */

/**
  * @brief  The application entry point.
  * @retval int
  */
int main(void)
{
  /* USER CODE BEGIN 1 */
	uint8_t		imu_readings[IMU_NUMBER_OF_BYTES];
	int16_t 	accel_data[3];
	float		acc_x, acc_y, acc_z;
  /* USER CODE END 1 */

  /* MCU Configuration--------------------------------------------------------*/

  /* Reset of all peripherals, Initializes the Flash interface and the Systick. */
  HAL_Init();

  /* Configure the system clock */
  SystemClock_Config();

  /* Initialize all configured peripherals */
  MX_GPIO_Init();
  MX_DMA_Init();
  MX_USART2_UART_Init();
  MX_I2C1_Init();
  /* USER CODE BEGIN 2 */
  printf("Hello\r\n");
  BNO055_Init_I2C(&hi2c1);
  /* USER CODE END 2 */

  /* Infinite loop */
  /* USER CODE BEGIN WHILE */
  while (1)
  {
	  HAL_Delay(300);
	  GetAccelData(&hi2c1, (uint8_t*)imu_readings);
	  accel_data[0] = (((int16_t)((uint8_t *)(imu_readings))[1] << 8) | ((uint8_t *)(imu_readings))[0]);      // Turn the MSB and LSB into a signed 16-bit value
	  accel_data[1] = (((int16_t)((uint8_t *)(imu_readings))[3] << 8) | ((uint8_t *)(imu_readings))[2]);
	  accel_data[2] = (((int16_t)((uint8_t *)(imu_readings))[5] << 8) | ((uint8_t *)(imu_readings))[4]);
	  acc_x = ((float)(accel_data[0]))/100.0f; //m/s2
	  acc_y = ((float)(accel_data[1]))/100.0f;
	  acc_z = ((float)(accel_data[2]))/100.0f;
	  printf("X: %.2f Y: %.2f Z: %.2f\r\n", acc_x, acc_y, acc_z);
    /* USER CODE END WHILE */

    /* USER CODE BEGIN 3 */
  }
  /* USER CODE END 3 */
}

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
