EnCl4/Alaris/Software/New/DAPU/Core/Src/sdmmc.c

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
/* Includes ------------------------------------------------------------------*/
#include "sdmmc.h"

SD_HandleTypeDef hsd1;

/* SDMMC1 init function */

void MX_SDMMC1_SD_Init(void)
{

  hsd1.Instance = SDMMC1;
  hsd1.Init.ClockEdge = SDMMC_CLOCK_EDGE_RISING;
  hsd1.Init.ClockPowerSave = SDMMC_CLOCK_POWER_SAVE_DISABLE;
  hsd1.Init.BusWide = SDMMC_BUS_WIDE_4B;
  hsd1.Init.HardwareFlowControl = SDMMC_HARDWARE_FLOW_CONTROL_DISABLE;
  hsd1.Init.ClockDiv = 2;
  if (HAL_SD_Init(&hsd1) != HAL_OK)
  {
    Error_Handler();
  }
  /* USER CODE BEGIN SDMMC1_Init 2 */
  /* NOT an Error_Handler() call on purpose.
   *
   * HAL_SD_Init() fails whenever no card is in the slot, and this runs before
   * the scheduler starts - halting here would make the whole DAPU dead on a
   * board with an empty slot, which is exactly the bring-up case. The card is
   * re-initialised later by BSP_SD_Init() from the SD_Writer task, which
   * retries f_mount() once a second, so a card inserted after power-up is
   * picked up automatically. */
  (void)HAL_SD_Init(&hsd1);
  /* USER CODE END SDMMC1_Init 2 */

}

void HAL_SD_MspInit(SD_HandleTypeDef* sdHandle)
{

  GPIO_InitTypeDef GPIO_InitStruct = {0};
  RCC_PeriphCLKInitTypeDef PeriphClkInitStruct = {0};
  if(sdHandle->Instance==SDMMC1)
  {
  /** Initializes the peripherals clock
  */
    PeriphClkInitStruct.PeriphClockSelection = RCC_PERIPHCLK_SDMMC;
    PeriphClkInitStruct.SdmmcClockSelection = RCC_SDMMCCLKSOURCE_PLL;
    if (HAL_RCCEx_PeriphCLKConfig(&PeriphClkInitStruct) != HAL_OK)
    {
      Error_Handler();
    }

    /* SDMMC1 clock enable */
    __HAL_RCC_SDMMC1_CLK_ENABLE();

    __HAL_RCC_GPIOC_CLK_ENABLE();
    __HAL_RCC_GPIOD_CLK_ENABLE();
    /**SDMMC1 GPIO Configuration
    PC8     ------> SDMMC1_D0
    PC9     ------> SDMMC1_D1
    PC10     ------> SDMMC1_D2
    PC11     ------> SDMMC1_D3
    PC12     ------> SDMMC1_CK
    PD2     ------> SDMMC1_CMD
    */
    GPIO_InitStruct.Pin = GPIO_PIN_8|GPIO_PIN_9|GPIO_PIN_10|GPIO_PIN_11
                          |GPIO_PIN_12;
    GPIO_InitStruct.Mode = GPIO_MODE_AF_PP;
    GPIO_InitStruct.Pull = GPIO_NOPULL;
    GPIO_InitStruct.Speed = GPIO_SPEED_FREQ_VERY_HIGH;
    GPIO_InitStruct.Alternate = GPIO_AF12_SDMMC1;
    HAL_GPIO_Init(GPIOC, &GPIO_InitStruct);

    GPIO_InitStruct.Pin = GPIO_PIN_2;
    GPIO_InitStruct.Mode = GPIO_MODE_AF_PP;
    GPIO_InitStruct.Pull = GPIO_NOPULL;
    GPIO_InitStruct.Speed = GPIO_SPEED_FREQ_VERY_HIGH;
    GPIO_InitStruct.Alternate = GPIO_AF12_SDMMC1;
    HAL_GPIO_Init(GPIOD, &GPIO_InitStruct);

    /* SDMMC1 interrupt Init */
    HAL_NVIC_SetPriority(SDMMC1_IRQn, 5, 0);
    HAL_NVIC_EnableIRQ(SDMMC1_IRQn);
  }
}

void HAL_SD_MspDeInit(SD_HandleTypeDef* sdHandle)
{

  if(sdHandle->Instance==SDMMC1)
  {
    /* Peripheral clock disable */
    __HAL_RCC_SDMMC1_CLK_DISABLE();

    /**SDMMC1 GPIO Configuration
    PC8     ------> SDMMC1_D0
    PC9     ------> SDMMC1_D1
    PC10     ------> SDMMC1_D2
    PC11     ------> SDMMC1_D3
    PC12     ------> SDMMC1_CK
    PD2     ------> SDMMC1_CMD
    */
    HAL_GPIO_DeInit(GPIOC, GPIO_PIN_8|GPIO_PIN_9|GPIO_PIN_10|GPIO_PIN_11
                          |GPIO_PIN_12);

    HAL_GPIO_DeInit(GPIOD, GPIO_PIN_2);

    /* SDMMC1 interrupt Deinit */
    HAL_NVIC_DisableIRQ(SDMMC1_IRQn);
  }
}
