EnCl4/Alaris/(commit log)

2026-02-18 Integração dos sensores
2026-03-01 Desenvolvimento do Hardware
    Desenvolvido os modulos de DAPN, GNCN, LDIN
    Ainda é necessario implementação de alguns sensores, e melhor o modulo de gerenciamento de energia da placa
    [ADA.kicad_sch, AlarisV1.0.kicad_sch, DAN.kicad_sch, DAPN.kicad_sch, DDA.kicad_sch, DataAcquire.kicad_sch, GNCN.kicad_sch, LDIN.kicad_sch]
2026-03-02 Hardware and Software
    Hardware: adição da proteção contra polaridade reversa
    Software: Adição dos arquivos iniciais de projeto do LDIN
    [AlarisV1.0.kicad_sch, PSN.kicad_sch]
2026-04-19 Desenvolvimento da PCB
    [ADA.kicad_sch, AlarisV1.0.csv, AlarisV1.0.kicad_pcb, AlarisV1.0.kicad_sch, Buzzer5mm.step, CMC-6022-42P--3DModel-STEP-1.STEP, CMT-0525-75-SMT-TR--3DModel-STEP-1.STEP, DAPN.kicad_sch]
2026-05-10 Mudanças GNCN
    Adição do acelerômetro de backup
    Mudanças no PWM read
    Adição da comunicação entre núcleos utilizando SPI
    [GNCN.kicad_sch]
2026-05-21 Mudanças preparatorias para PID
    Finalização da adição da emissão dos sinais PWM para controle dos servos
    Criação de uma estrurura base/função do PID. Necessario revisar e verificar variavel de tempo a partir do clock do sistema, e definir prioridade da função
2026-05-25 Malha de controle de phi
    Adição das tasks e funções de controle basica para o phi
