EnCl4/Alaris/(notices)

Notices in the files:
BibliotecasSoft/bno055-master-f2738bed38962437c4694702e65aabc566cbee7b/bno055/Src/main.c:
COPYRIGHT(c) 2019 STMicroelectronics
(C) COPYRIGHT STMicroelectronics *****END OF FILE
BibliotecasSoft/stm32-ublox-ubx-parser-main/Example CubeIDE Project/Core/Inc/main.h:
© Copyright (c) 2021 STMicroelectronics.
All rights reserved.
This software component is licensed by ST under BSD 3-Clause license,
the "License"; You may not use this file except in compliance with the
License. You may obtain a copy of the License at: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
Software/New/DAPU/Core/Src/sdmmc.c:
Copyright (c) 2026 STMicroelectronics.
This software is licensed under terms that can be found in the LICENSE file
Alaris - Hardware/Biblioteca/Step/MTSW-101-X-X-D-X.step:
author */ ('License CC BY-ND 4.0'),
